patrickstreit/PD240W/PCB_files/production/bom.csv

Designator | Footprint | Quantity | Value | LCSC Part #
C1, C2, C5 | capc_1005_06_n | 3 | 10n X7R 100V | C527014
C10, C11, C12, C28, C29, C59, C60, C61, C67, C9 | capc_3225_27_n | 10 | 10u X7R 63V | C437568
C13, C14, C15 | capc_1608_09_n | 3 | 3.3u X5R 25V | C5360803
C16, C17, C21, C22, C23, C24, C25, C26, C27, C30, C34, C35, C37, C38, C39, C4, C40, C41, C42, C43, C44, C47, C48, C49, C50, C52, C53, C54, C55, C6, C63, C8 | capc_1608_09_l | 32 | 100n X7R 100V | C15725
C18 | capc_2012_14_m | 1 | 2.2u X7R 100V | C22367838
C19, C20 | capc_1005_06_l | 2 | 220p X7R 50V | C296710
C3 | capc_3225_22_n | 1 | 4.7u | C913445
C31, C32, C33, C36, C51, C56, C57, C58, C62, C64, C65, C66, C7 | capc_2012_14_n | 13 | 1u X7R 100V | C5370002
C45, C46 | capc_1005_06_n | 2 | 15p COG 50V | C1548
D1, D8 | do-214ac_440p_430x250x230_n_p | 2 | SMAJ48A | C41376401
D10, D7 | sot363_sc88_65p_200x125x110_n | 2 | D3V3F4U6S-7 | C1869321
D11 | SK6812-EC20 | 1 | SK6812-EC20 | C2909058
D12, D13 | sod-123fl_305p_260x160x90_n | 2 | MBR1H100SFT3G | C235757
D14, D4, D6, D9 | kingbright_0603_blue | 4 | APTD1608LQBC/D | C5344742
D2, D3 | sod-323_230p_170x125x100_n | 2 | BZT52C18SQ | C2857090
D5 | sod-123_270x155135_n | 1 | B0520LW-7-F | C155367
DSP1 | generic_display_518x362x2_10mm_standoff | 1 | HS20HS072RX | C5329582
F1, F2 | ptc_1206_08_n | 2 | FSMD020-1206-R | C220145
FB1 | fer_1608_09_n | 1 | BLM18SN220TH1D | C710392
J1 | DX07S024JJ2R1300 | 1 | DX07S024JJ2R1300 | C2977282
J3 | fcr7350r | 1 | 24.245.1 | C7437326
J4 | fcr7350b | 1 | 24.245.2 | C7437327
J5, J6 | phoenix_1935776 | 2 | 1935776 | C3817389
J8 | AFC07-S12FCA-00 | 1 | AFC07-S12FCA-00 | C262559
L1 | SWPA4030S220MT | 1 | 22uH 1A 0.29Ohm | C83472
L2 | SWPA4030S220MT | 1 | 68uH 0.55A 0.91Ohm | C340217
PZ1 | buzzer_9x9x2.1mm | 1 | FUET-9018 | C391035
Q1 | vsonp8_65p_330x330x80_mfg | 1 | AGM612AP | C5349119
Q2, Q4, Q5, Q6, Q7 | sot-23-3L_103p_300x130x110_n | 5 | AO3404A | C30010
Q3 | PowerPAKSO-8_127p_513x615x120_n | 1 | SQJB90EP-T1_GE3 | C727731
R1, R14, R15, R16, R17, R21, R27, R28, R29, R3, R75, R81, R85, R87, R88 | resc_1005_04_m | 15 | 100k 1% | C25741
R10, R13, R19, R31, R36, R41, R6, R69, R70, R71, R76, R77, R83, R86 | resc_1005_04_n | 14 | 10k 1% | C25744
R11, R12, R18, R25, R30, R8, R84, R89, R9, R90 | resc_1005_04_m | 10 | 4.7k 1% | C25900
R2, R33, R34, R4, R72, R78, R79, R80, R82 | resc_1005_04_n | 9 | 33k 1% | C138003
R20, R50, R68 | resc_1005_04_m | 3 | 330R 1% | C25104
R22 | WSLP1206_n_current_sense_6m_to_50m | 1 | 8m 1% | C2988654
R23, R24, R26, R37, R38, R39, R40, R42, R43, R44, R45, R46, R47, R48, R49, R51, R52, R56, R57, R58, R59, R60, R61, R62, R64, R65, R66, R7, R74 | resc_1005_04_m | 29 | 27R 1% | C138021
R32 | resc_1005_04_m | 1 | 10k @25°C | C95939
R35, R5, R53, R54, R55, R63, R67 | resc_1005_04_m | 7 | 1k 1% | C11702
R73 | resc_1005_04_m | 1 | 3.9R 1% | C2933095
S1, S2 | EVQPUC02K | 2 | EVQ-PUC02K | C79174
S3 | PEC11R-4215F-S0024 | 1 | PEC11R-4215F-S0024 | C143790
S4, S5 | GT-TC120A-H120-L1 | 2 | GT-TC120A-H120-L1 | C2762973
U1 | wqfn20_40p_300x300x80_tp_170x170_n | 1 | TPD4S480RUKR | C43131250
U10 | wson8_127p_600x500x80_tp_435x340_n | 1 | W25Q128JVPIQ | C190862
U11, U12 | sot6_p95_290x180x110_n | 2 | LMR16006XDDCR | C87080
U2 | sot236_p95_290x160x110_n | 1 | LM2765 | C140270
U3 | qfn32_40p_400x400x100_tp_280x280_mfg | 1 | TPS26750SRSMR | C42166327
U4 | msop_10p_300x490x110_tp168x188_n | 1 | LTC7004x | C690106
U5 | sot353_65p_200x125x110_mo-203-aa_n | 1 | 74LVC1G08SE-7 | C460522
U6 | JEDEC_MO-153_AA | 1 | CAT24C512YI-GT3 | C56096
U7 | sot25_95p_300x280x145_jedec_mo-178-aa_n | 1 | SN74LVC1G17DBVR | C7836
U8 | vssop10_50p_300x300x110_mfg | 1 | INA228AIDGSR | C2887910
U9 | qfn56_40p_700x700x90_tp_320x320_mfg | 1 | RP2040 | C2040
Y1 | osccc_320x205x80_abm8 | 1 | ABM8-272-T3 | C20625731
