patrickstreit/PD240W/PCB_files/PD240W_kicad.kicad_pcb

## KiCad design PCB_files/PD240W_kicad.kicad_pcb (2026-11-01)

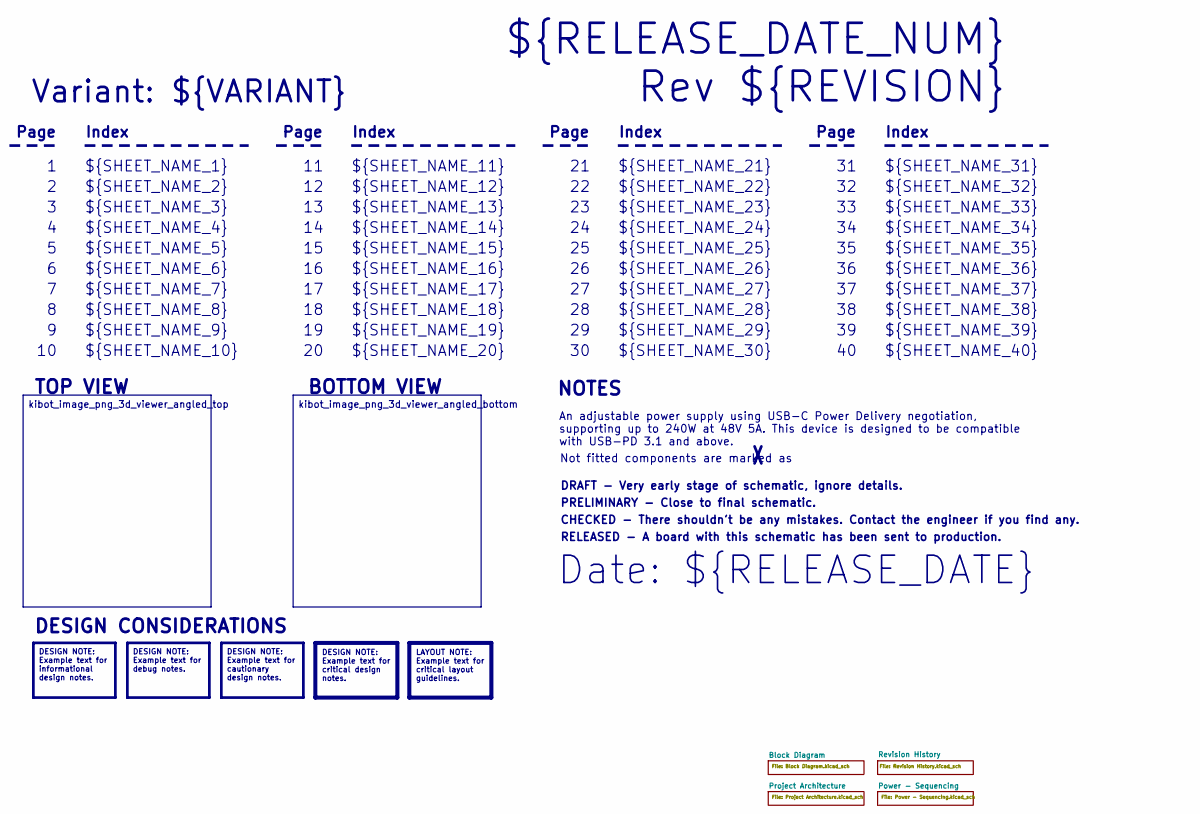
[picture p1: schematic PD240W_kicad.kicad_sch]

Notes on the sheet:
Variant: ${VARIANT}
RELEASED - A board with this schematic has been sent to production.
${SHEET_NAME_24}
Index
Page
PRELIMINARY - Close to final schematic.
${SHEET_NAME_22}
DRAFT - Very early stage of schematic, ignore details.
${SHEET_NAME_12}
${SHEET_NAME_8}
${SHEET_NAME_2}
${SHEET_NAME_5}
${SHEET_NAME_20}
${SHEET_NAME_23}
${RELEASE_DATE_NUM}
${SHEET_NAME_35}
Not fitted components are marked as
${SHEET_NAME_11}
${SHEET_NAME_6}
${SHEET_NAME_37}
${SHEET_NAME_26}
${SHEET_NAME_36}
Rev ${REVISION}
${SHEET_NAME_15}
CHECKED - There shouldn't be any mistakes. Contact the engineer if you find any.
BOTTOM VIEW
${SHEET_NAME_14}
${SHEET_NAME_21}
${SHEET_NAME_17}
${SHEET_NAME_18}
Date: ${RELEASE_DATE}
${SHEET_NAME_7}
${SHEET_NAME_31}
NOTES
${SHEET_NAME_40}
${SHEET_NAME_39}
${SHEET_NAME_32}
${SHEET_NAME_1}
${SHEET_NAME_9}
${SHEET_NAME_38}
${SHEET_NAME_29}
${SHEET_NAME_34}
${SHEET_NAME_16}
${SHEET_NAME_3}
${SHEET_NAME_19}
TOP VIEW
${SHEET_NAME_10}
${SHEET_NAME_28}
${SHEET_NAME_13}
${SHEET_NAME_27}
${SHEET_NAME_4}
${SHEET_NAME_33}
${SHEET_NAME_30}
${SHEET_NAME_25}
DESIGN CONSIDERATIONS
DESIGN NOTE: Example text for cautionary design notes.
DESIGN NOTE: Example text for debug notes.
DESIGN NOTE: Example text for critical design notes.
LAYOUT NOTE: Example text for critical layout guidelines.
kibot_image_png_3d_viewer_angled_bottom
DESIGN NOTE: Example text for informational design notes.
An adjustable power supply using USB-C Power Delivery negotiation, supporting up to 240W at 48V 5A. This device is designed to be compatible with USB-PD 3.1 and above.
kibot_image_png_3d_viewer_angled_top

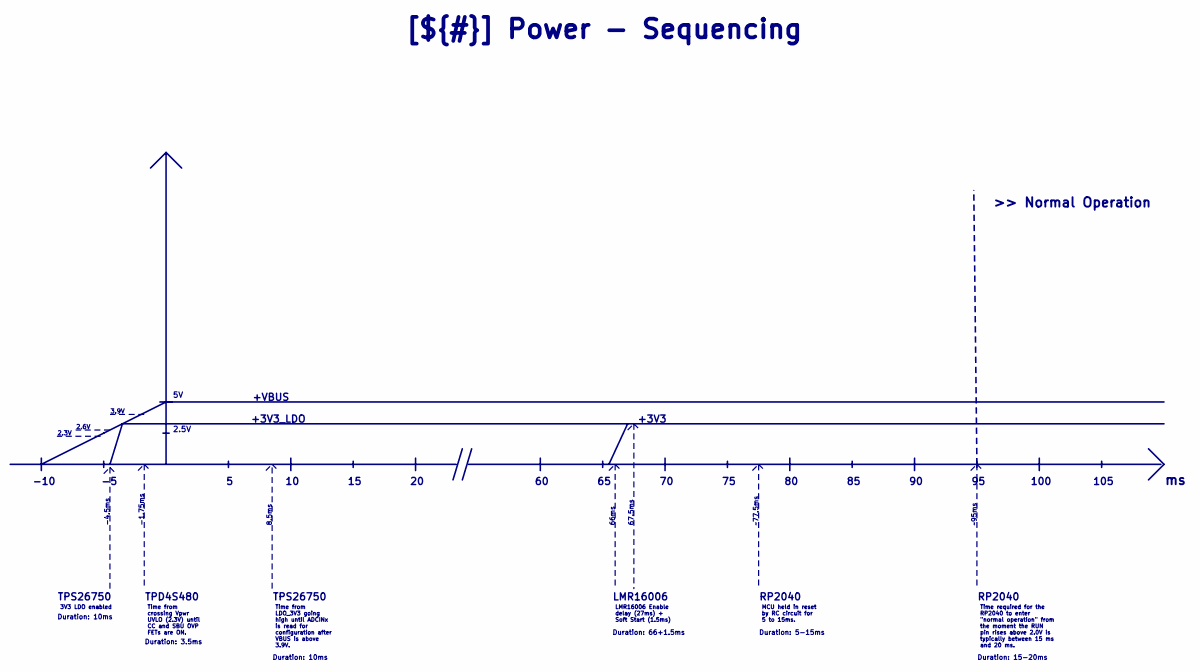
[picture p2: schematic Power - Sequencing.kicad_sch]

Notes on the sheet:
~95ms
-1.75ms
2.5V
3.9V
Duration: 15-20ms
RP2040
TPS26750
LMR16006
2.6V
+VBUS
Duration: 10ms
100
Duration: 3.5ms
Duration: 66+1.5ms
8.5ms
+3V3_LDO
66ms
67.5ms
Duration: 5-15ms
2.3V
105
~77.5ms
TPD4S480
+3V3
>> Normal Operation
-4.5ms
-10
3V3 LDO enabled
Time from LDO_3V3 going high until ADCINx is read for configuration after VBUS is above 3.9V.
Time from crossing Vpwr UVLO (2.3V) until CC and SBU OVP FETs are ON.
Time required for the RP2040 to enter "normal operation" from the moment the RUN pin rises above 2.0V is typically between 15 ms and 20 ms.
[${#}] ${TITLE}
MCU held in reset by RC circuit for 5 to 15ms.
LMR16006 Enable delay (27ms) + Soft Start (1.5ms)


Notes on the sheet:
${RELEASE_BODY_1.1.0}
[${#}] ${TITLE}
${RELEASE_BODY_1.0.0}
${RELEASE_TITLE_1.0.2}
${RELEASE_BODY_1.0.2}
${RELEASE_BODY_1.0.1}
${RELEASE_TITLE_1.0.0}
${RELEASE_TITLE_1.0.1}
${RELEASE_TITLE_1.1.0}

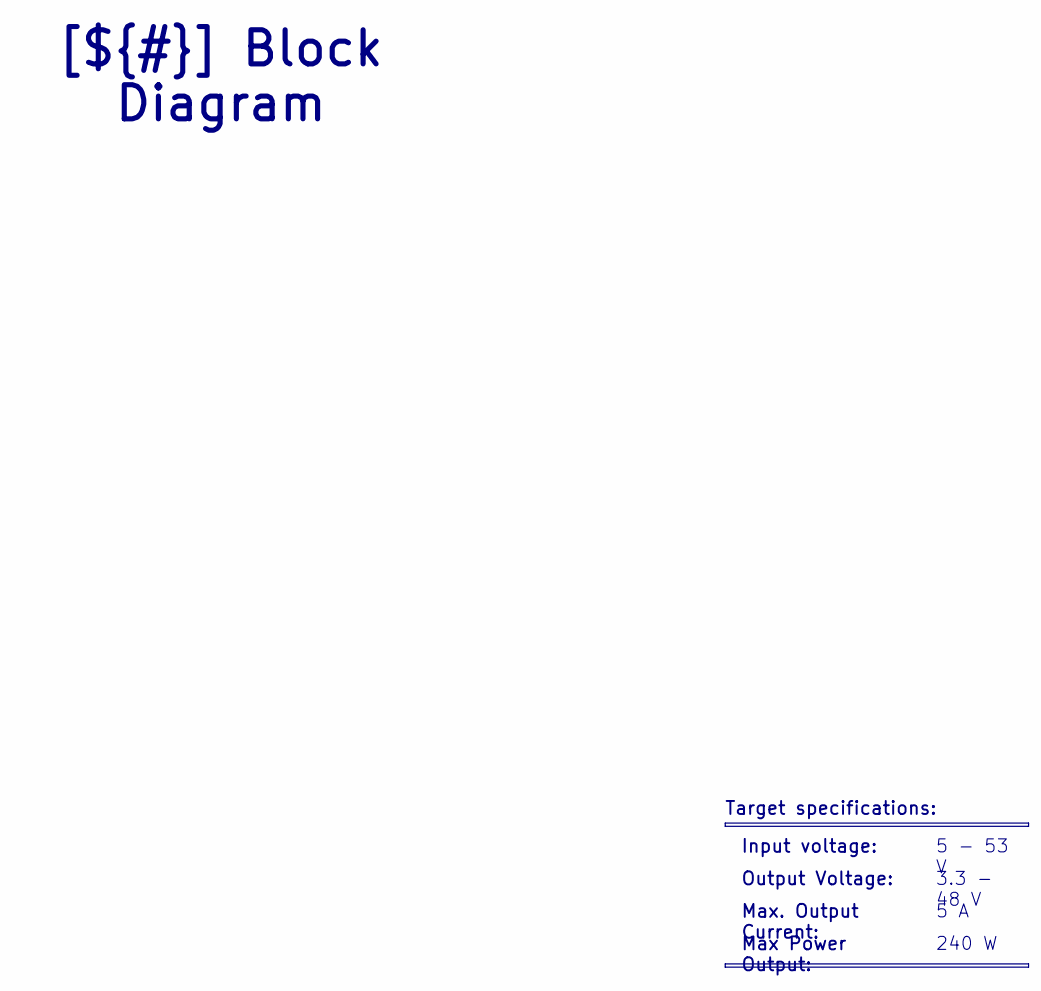
[picture p4: schematic Block Diagram.kicad_sch]

Notes on the sheet:
Max Power Output:
5 - 53 V
240 W
[${#}] ${TITLE}
3.3 - 48 V
Input voltage:
Target specifications:
Max. Output Current:
5 A
Output Voltage:

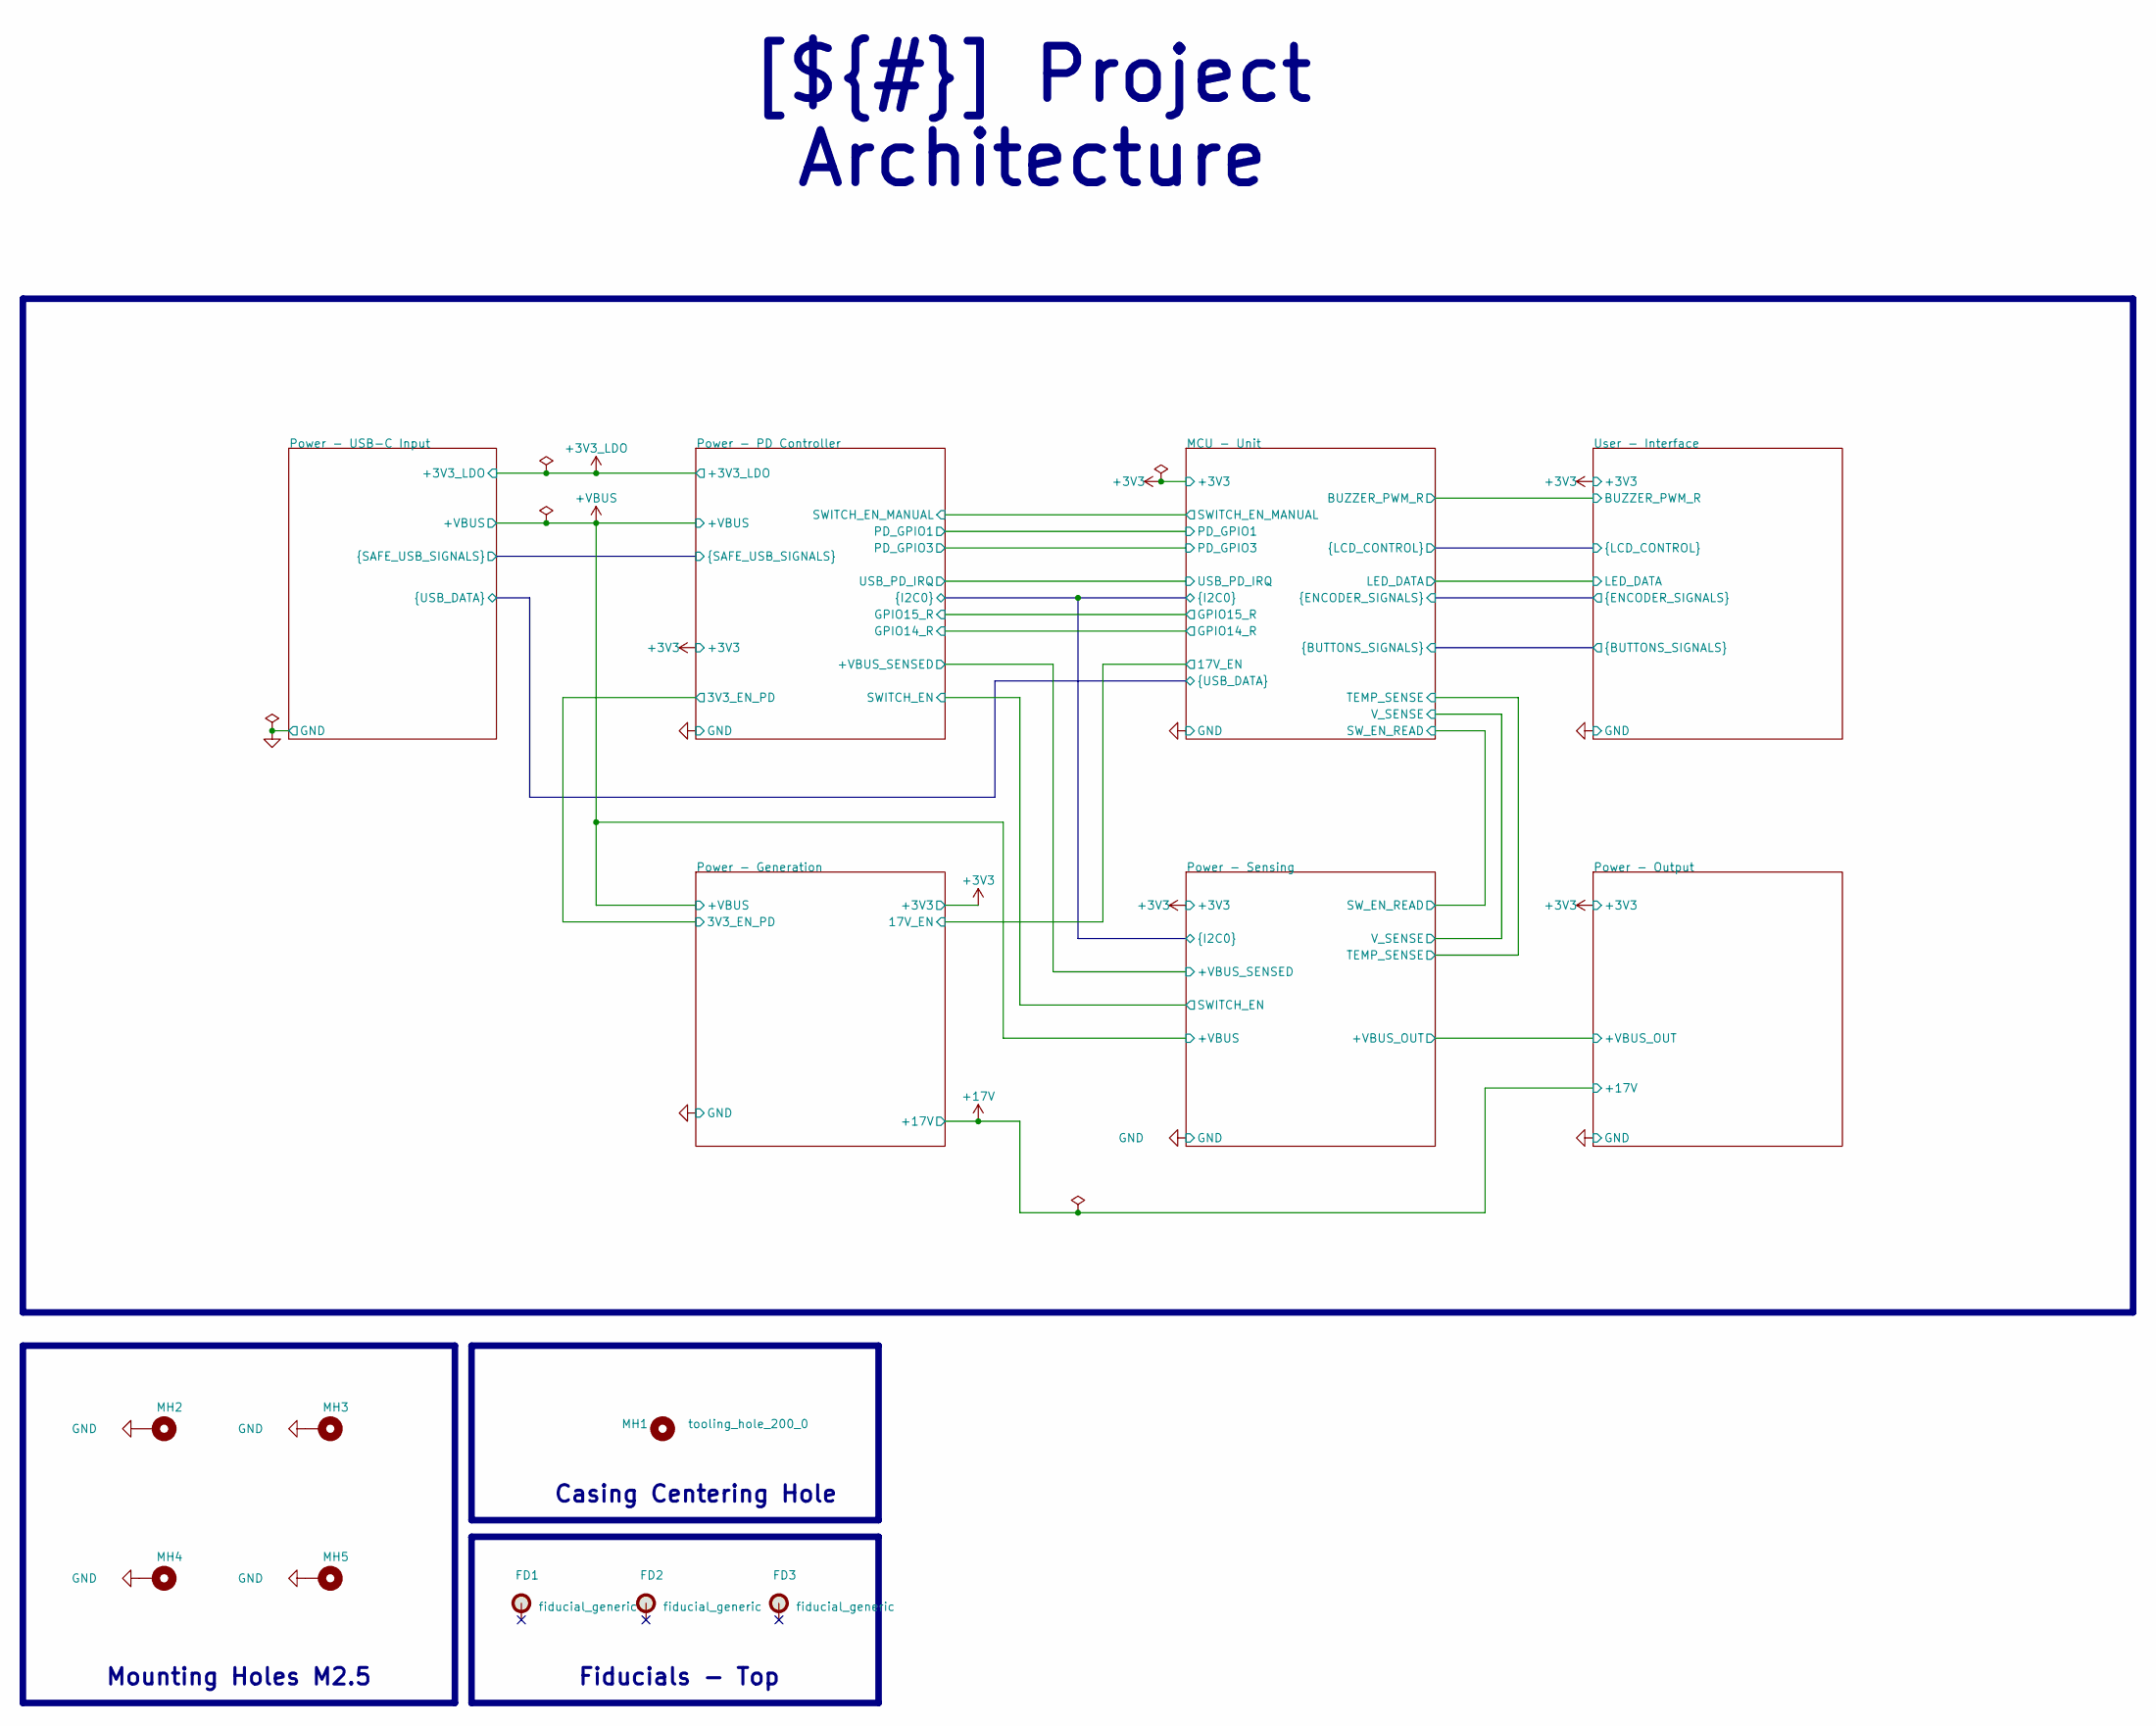
[picture p5: schematic Project Architecture.kicad_sch]

Parts:
FD1, FD2, FD3: fiducial_generic; fiducial_round_130
MH1: tooling_hole_200_0; tooling_hole_200_0_np
MH2, MH3, MH4, MH5: mounting_hole_270_540_p_via_8_50; MountingHole_2.7mm_M2.5_Pad_Via

Connections:
GND: MH2.1 (1_1), MH3.1 (1_1), MH4.1 (1_1), MH5.1 (1_1); also elsewhere on the board

Notes on the sheet:
Mounting Holes M2.5
Casing Centering Hole
Fiducials - Top
[${#}] ${TITLE}

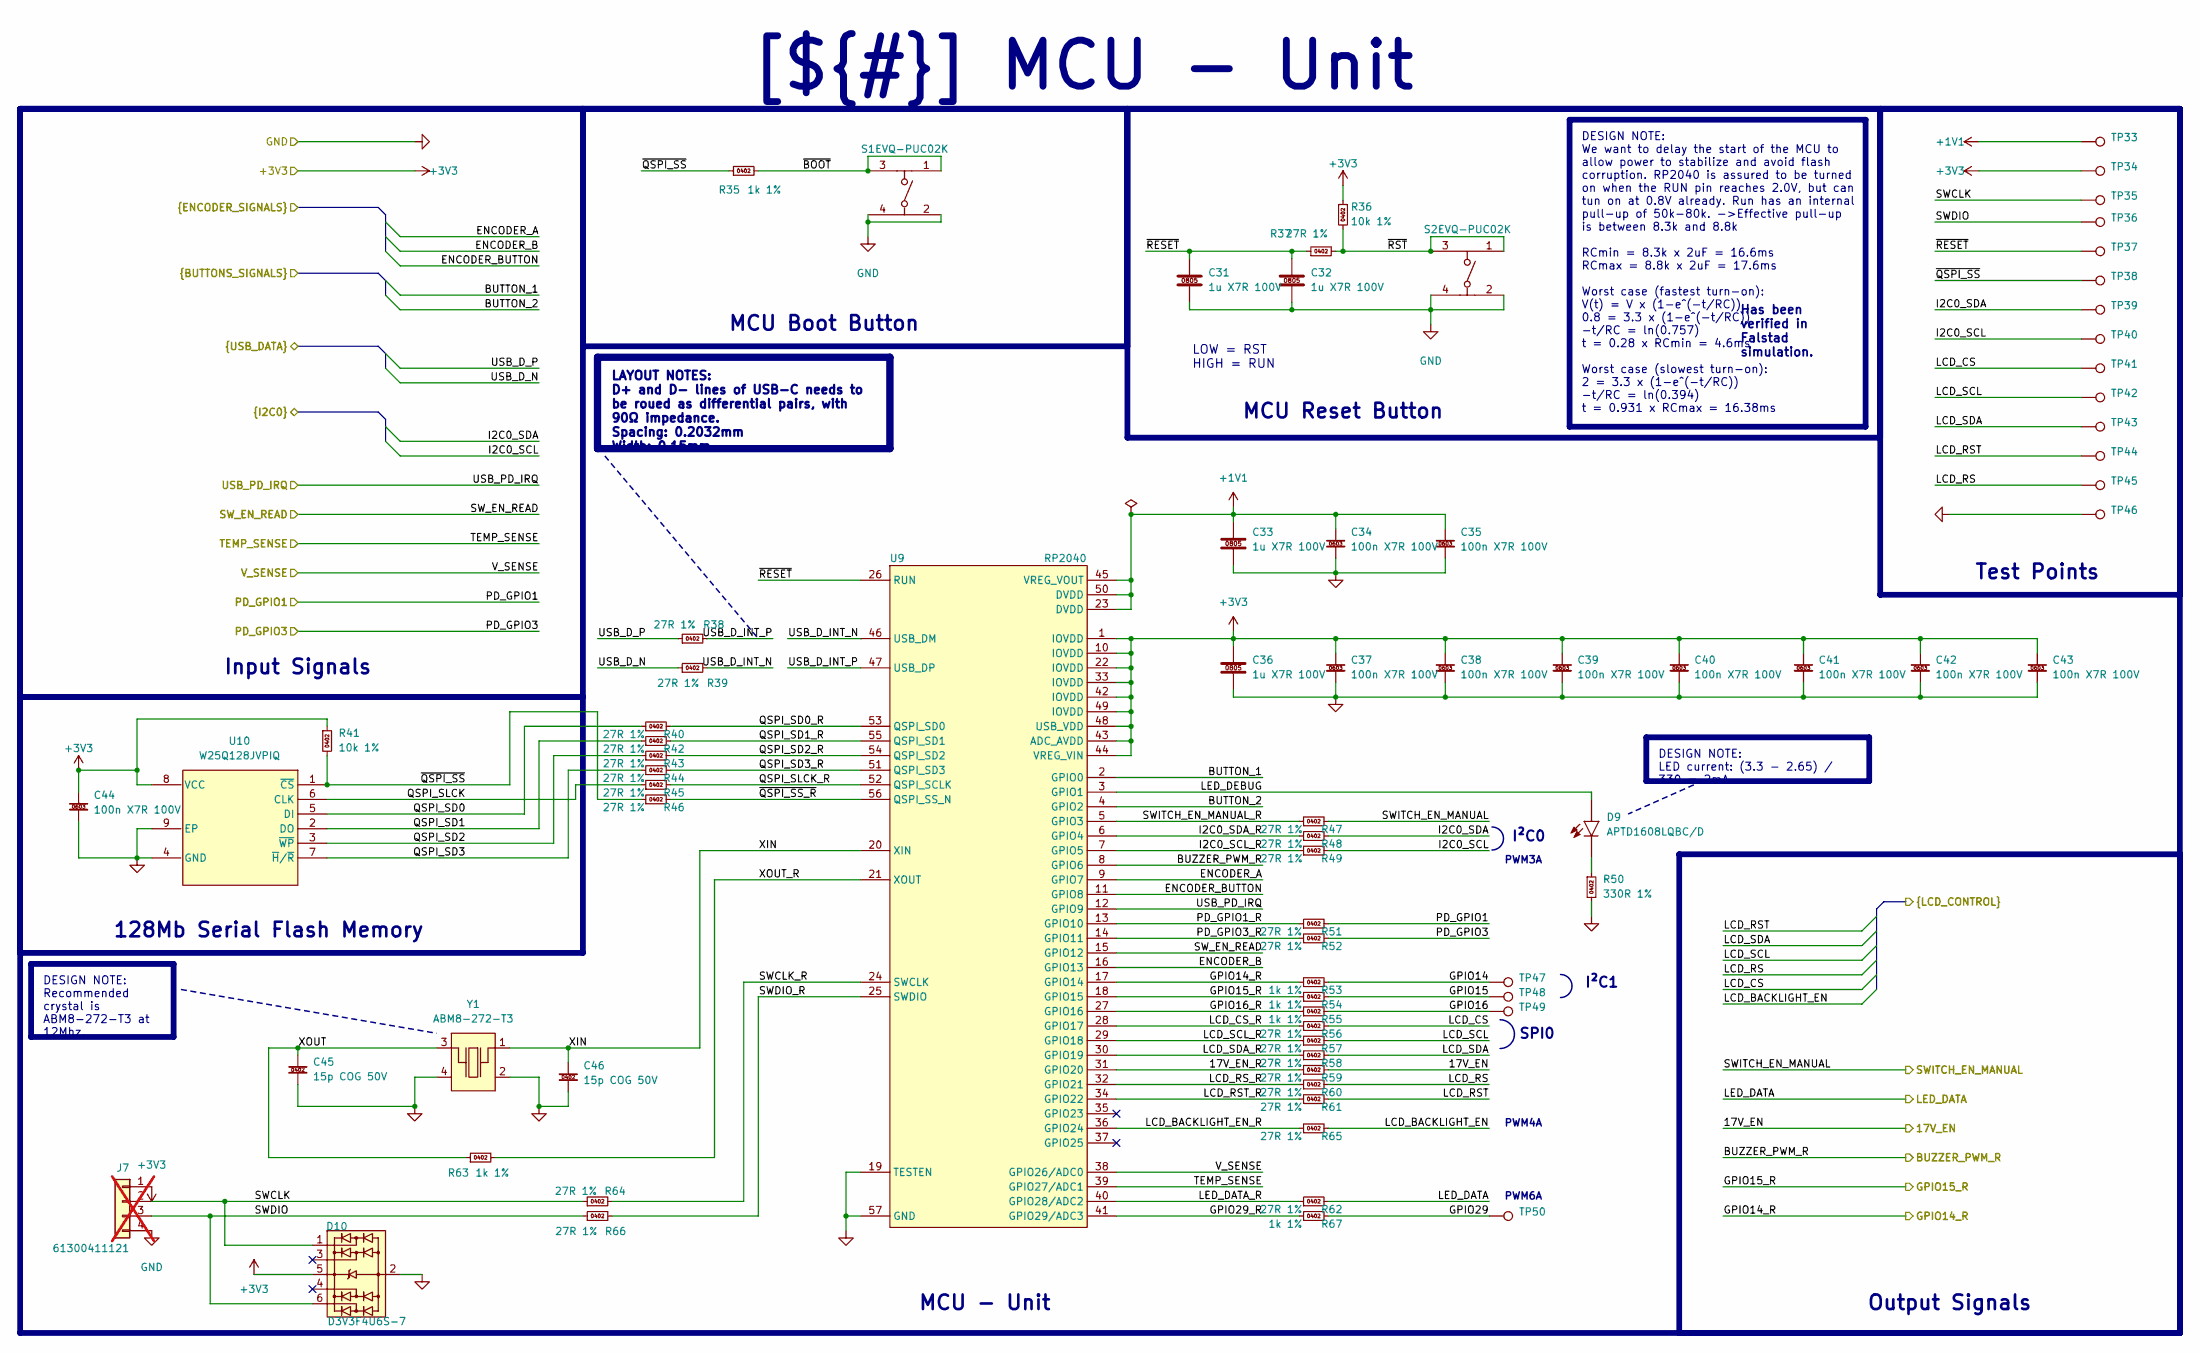
[picture p6: schematic mcu_unit.kicad_sch, MCU - Unit]

Parts:
C31, C32, C33, C36: 1u X7R 100V; capc_2012_14_n; Manufacturer Part Number CC0805KKX7R0BB105; LCSC C5370002
C34, C35, C37, C38, C39, C40, C41, C42, C43, C44: 100n X7R 100V; capc_1608_09_l; Manufacturer Part Number CL10B104KC8NNNC; LCSC C15725
C45, C46: 15p COG 50V; capc_1005_06_n; Manufacturer Part Number 0402CG150J500NT; LCSC C1548
D9: APTD1608LQBC/D; kingbright_0603_blue; Manufacturer Part Number APTD1608LQBC/D; LCSC C5344742
D10: D3V3F4U6S-7; sot363_sc88_65p_200x125x110_n; Manufacturer Part Number D3V3F4U6S-7; LCSC C1869321
J7: 61300411121; we_61300411121; Manufacturer Part Number 61300411121; LCSC C5184785; not fitted
R35, R53, R54, R55, R63, R67: 1k 1%; resc_1005_04_m; Manufacturer Part Number 0402WGF1001TCE; LCSC C11702
R36, R41: 10k 1%; resc_1005_04_n; Manufacturer Part Number 0402WGF1002TCE; LCSC C25744
R37, R38, R39, R40, R42, R43, R44, R45, R46, R47, R48, R49, R51, R52, R56, R57, R58, R59, R60, R61, R62, R64, R65, R66: 27R 1%; resc_1005_04_m; Manufacturer Part Number RC0402FR-0727RL; LCSC C138021
R50: 330R 1%; resc_1005_04_m; Manufacturer Part Number 0402WGF3300TCE; LCSC C25104
S1, S2: EVQ-PUC02K; EVQPUC02K; Manufacturer Part Number EVQ-PUC02K; LCSC C79174
TP33, TP34, TP35, TP36, TP37, TP38, TP39, TP40, TP41, TP42, TP43, TP44, TP45: tp_round_70
TP46, TP47, TP48, TP49, TP50: sp_oval_300x100
U9: RP2040; qfn56_40p_700x700x90_tp_320x320_mfg; Manufacturer Part Number SC0914(13); LCSC C2040
U10: W25Q128JVPIQ; wson8_127p_600x500x80_tp_435x340_n; Manufacturer Part Number W25Q128JVPIQ; LCSC C190862
Y1: ABM8-272-T3; osccc_320x205x80_abm8; Manufacturer Part Number ABM8-272-T3; LCSC C20625731

Connections:
+1V1: C33.1, C34.1, C35.1, TP33.1 (1_1), U9.23 (DVDD), U9.45 (VREG_VOUT), U9.50 (DVDD)
+3V3: C36.1, C37.1, C38.1, C39.1, C40.1, C41.1, C42.1, C43.1, C44.1, D10.5, J7.1, R36.1, R41.1, TP34.1 (1_1), U9.1 (IOVDD), U9.10 (IOVDD), U9.22 (IOVDD), U9.33 (IOVDD), U9.42 (IOVDD), U9.43 (ADC_AVDD), U9.44 (VREG_VIN), U9.48 (USB_VDD), U9.49 (IOVDD), U10.8 (VCC); also elsewhere on the board
/Project Architecture/MCU - Unit/17V_EN: R59.2; also elsewhere on the board
/Project Architecture/MCU - Unit/17V_EN_R: R59.1, U9.31 (GPIO20)
/Project Architecture/MCU - Unit/BUTTON_1: U9.2 (GPIO0); also elsewhere on the board
/Project Architecture/MCU - Unit/BUTTON_2: U9.4 (GPIO2); also elsewhere on the board
/Project Architecture/MCU - Unit/BUZZER_PWM_R: U9.8 (GPIO6); also elsewhere on the board
/Project Architecture/MCU - Unit/ENCODER_A: U9.9 (GPIO7); also elsewhere on the board
/Project Architecture/MCU - Unit/ENCODER_B: U9.16 (GPIO13); also elsewhere on the board
/Project Architecture/MCU - Unit/ENCODER_BUTTON: U9.11 (GPIO8); also elsewhere on the board
/Project Architecture/MCU - Unit/GPIO14: R53.2, TP47.1 (1_1)
/Project Architecture/MCU - Unit/GPIO14_R: R53.1, U9.17 (GPIO14); also elsewhere on the board
/Project Architecture/MCU - Unit/GPIO15: R54.2, TP48.1 (1_1)
/Project Architecture/MCU - Unit/GPIO15_R: R54.1, U9.18 (GPIO15); also elsewhere on the board
/Project Architecture/MCU - Unit/GPIO16: R55.2, TP49.1 (1_1)
/Project Architecture/MCU - Unit/GPIO16_R: R55.1, U9.27 (GPIO16)
/Project Architecture/MCU - Unit/GPIO29: R67.2, TP50.1 (1_1)
/Project Architecture/MCU - Unit/GPIO29_R: R67.1, U9.41 (GPIO29/ADC3)
/Project Architecture/MCU - Unit/I2C0_SCL: R49.2, TP40.1 (1_1); also elsewhere on the board
/Project Architecture/MCU - Unit/I2C0_SCL_R: R49.1, U9.7 (GPIO5)
/Project Architecture/MCU - Unit/I2C0_SDA: R48.2, TP39.1 (1_1); also elsewhere on the board
/Project Architecture/MCU - Unit/I2C0_SDA_R: R48.1, U9.6 (GPIO4)
/Project Architecture/MCU - Unit/LCD_BACKLIGHT_EN: R65.2; also elsewhere on the board
/Project Architecture/MCU - Unit/LCD_BACKLIGHT_EN_R: R65.1, U9.36 (GPIO24)
/Project Architecture/MCU - Unit/LCD_CS: R56.2, TP41.1 (1_1); also elsewhere on the board
/Project Architecture/MCU - Unit/LCD_CS_R: R56.1, U9.28 (GPIO17)
/Project Architecture/MCU - Unit/LCD_RS: R60.2, TP45.1 (1_1); also elsewhere on the board
/Project Architecture/MCU - Unit/LCD_RST: R61.2, TP44.1 (1_1); also elsewhere on the board
/Project Architecture/MCU - Unit/LCD_RST_R: R61.1, U9.34 (GPIO22)
/Project Architecture/MCU - Unit/LCD_RS_R: R60.1, U9.32 (GPIO21)
/Project Architecture/MCU - Unit/LCD_SCL: R57.2, TP42.1 (1_1); also elsewhere on the board
/Project Architecture/MCU - Unit/LCD_SCL_R: R57.1, U9.29 (GPIO18)
/Project Architecture/MCU - Unit/LCD_SDA: R58.2, TP43.1 (1_1); also elsewhere on the board
/Project Architecture/MCU - Unit/LCD_SDA_R: R58.1, U9.30 (GPIO19)
/Project Architecture/MCU - Unit/LED_DATA: R62.2; also elsewhere on the board
/Project Architecture/MCU - Unit/LED_DATA_R: R62.1, U9.40 (GPIO28/ADC2)
/Project Architecture/MCU - Unit/LED_DEBUG: D9.2 (A), U9.3 (GPIO1)
/Project Architecture/MCU - Unit/PD_GPIO1: R51.2; also elsewhere on the board
/Project Architecture/MCU - Unit/PD_GPIO1_R: R51.1, U9.13 (GPIO10)
/Project Architecture/MCU - Unit/PD_GPIO3: R52.2; also elsewhere on the board
/Project Architecture/MCU - Unit/PD_GPIO3_R: R52.1, U9.14 (GPIO11)
/Project Architecture/MCU - Unit/QSPI_SD0: R40.1, U10.5 (DI)
/Project Architecture/MCU - Unit/QSPI_SD0_R: R40.2, U9.53 (QSPI_SD0)
/Project Architecture/MCU - Unit/QSPI_SD1: R42.1, U10.2 (DO)
/Project Architecture/MCU - Unit/QSPI_SD1_R: R42.2, U9.55 (QSPI_SD1)
/Project Architecture/MCU - Unit/QSPI_SD2: R43.1, U10.3 (~WP)
/Project Architecture/MCU - Unit/QSPI_SD2_R: R43.2, U9.54 (QSPI_SD2)
/Project Architecture/MCU - Unit/QSPI_SD3: R44.1, U10.7 (~H/~R)
/Project Architecture/MCU - Unit/QSPI_SD3_R: R44.2, U9.51 (QSPI_SD3)
/Project Architecture/MCU - Unit/QSPI_SLCK: R45.1, U10.6 (CLK)
/Project Architecture/MCU - Unit/QSPI_SLCK_R: R45.2, U9.52 (QSPI_SCLK)
/Project Architecture/MCU - Unit/SWCLK: D10.1, J7.2, R64.1, TP35.1 (1_1)
/Project Architecture/MCU - Unit/SWCLK_R: R64.2, U9.24 (SWCLK)
/Project Architecture/MCU - Unit/SWDIO: D10.6, J7.3, R66.1, TP36.1 (1_1)
/Project Architecture/MCU - Unit/SWDIO_R: R66.2, U9.25 (SWDIO)
/Project Architecture/MCU - Unit/SWITCH_EN_MANUAL: R47.2; also elsewhere on the board
/Project Architecture/MCU - Unit/SWITCH_EN_MANUAL_R: R47.1, U9.5 (GPIO3)
/Project Architecture/MCU - Unit/SW_EN_READ: U9.15 (GPIO12); also elsewhere on the board
/Project Architecture/MCU - Unit/TEMP_SENSE: U9.39 (GPIO27/ADC1); also elsewhere on the board
/Project Architecture/MCU - Unit/USB_D_INT_N: R39.2, U9.46 (USB_DM)
/Project Architecture/MCU - Unit/USB_D_INT_P: R38.2, U9.47 (USB_DP)
/Project Architecture/MCU - Unit/USB_D_N: R39.1; also elsewhere on the board
/Project Architecture/MCU - Unit/USB_D_P: R38.1; also elsewhere on the board
/Project Architecture/MCU - Unit/USB_PD_IRQ: U9.12 (GPIO9); also elsewhere on the board
/Project Architecture/MCU - Unit/V_SENSE: U9.38 (GPIO26/ADC0); also elsewhere on the board
/Project Architecture/MCU - Unit/XIN: C46.1, U9.20 (XIN), Y1.1
/Project Architecture/MCU - Unit/XOUT: C45.1, R63.1, Y1.3
/Project Architecture/MCU - Unit/XOUT_R: R63.2, U9.21 (XOUT)
/Project Architecture/MCU - Unit/~BOOT: R35.2, S1.1, S1.3
/Project Architecture/MCU - Unit/~QSPI_SS_R: R46.2, U9.56 (QSPI_SS_N)
/Project Architecture/MCU - Unit/~QSPI_SS: R35.1, R41.2, R46.1, TP38.1 (1_1), U10.1 (~CS)
/Project Architecture/MCU - Unit/~RESET: C31.1, C32.1, R37.1, TP37.1 (1_1), U9.26 (RUN)
/Project Architecture/MCU - Unit/~RST: R36.2, R37.2, S2.1, S2.3
GND: C31.2, C32.2, C33.2, C34.2, C35.2, C36.2, C37.2, C38.2, C39.2, C40.2, C41.2, C42.2, C43.2, C44.2, C45.2, C46.2, D10.2, J7.4, R50.2, S1.2, S1.4, S2.2, S2.4, TP46.1 (1_1), U9.19 (TESTEN), U9.57 (GND), U10.4 (GND), U10.9 (EP), Y1.2, Y1.4; also elsewhere on the board
unnamed: D9.1 (C), R50.1

Notes on the sheet:
PWM4A
MCU Boot Button
MCU Reset Button
Input Signals
128Mb Serial Flash Memory
Test Points
I²C1
Output Signals
SPI0
I²C0
PWM6A
${TITLE}
PWM3A
LOW = RST HIGH = RUN
LAYOUT NOTES: D+ and D- lines of USB-C needs to be roued as differential pairs, with 90Ω impedance. Spacing: 0.2032mm Width: 0.15mm
DESIGN NOTE: We want to delay the start of the MCU to allow power to stabilize and avoid flash corruption. RP2040 is assured to be turned on when the RUN pin reaches 2.0V, but can tun on at 0.8V already. Run has an internal pull-up of 50k-80k. ->Effective pull-up is between 8.3k and 8.8k RCmin = 8.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
DESIGN NOTE: Recommended crystal is ABM8-272-T3 at 12Mhz.
Has been verified in Falstad simulation.
DESIGN NOTE: LED current: (3.3 - 2.65) / 330 = 2mA
[${#}] ${TITLE}

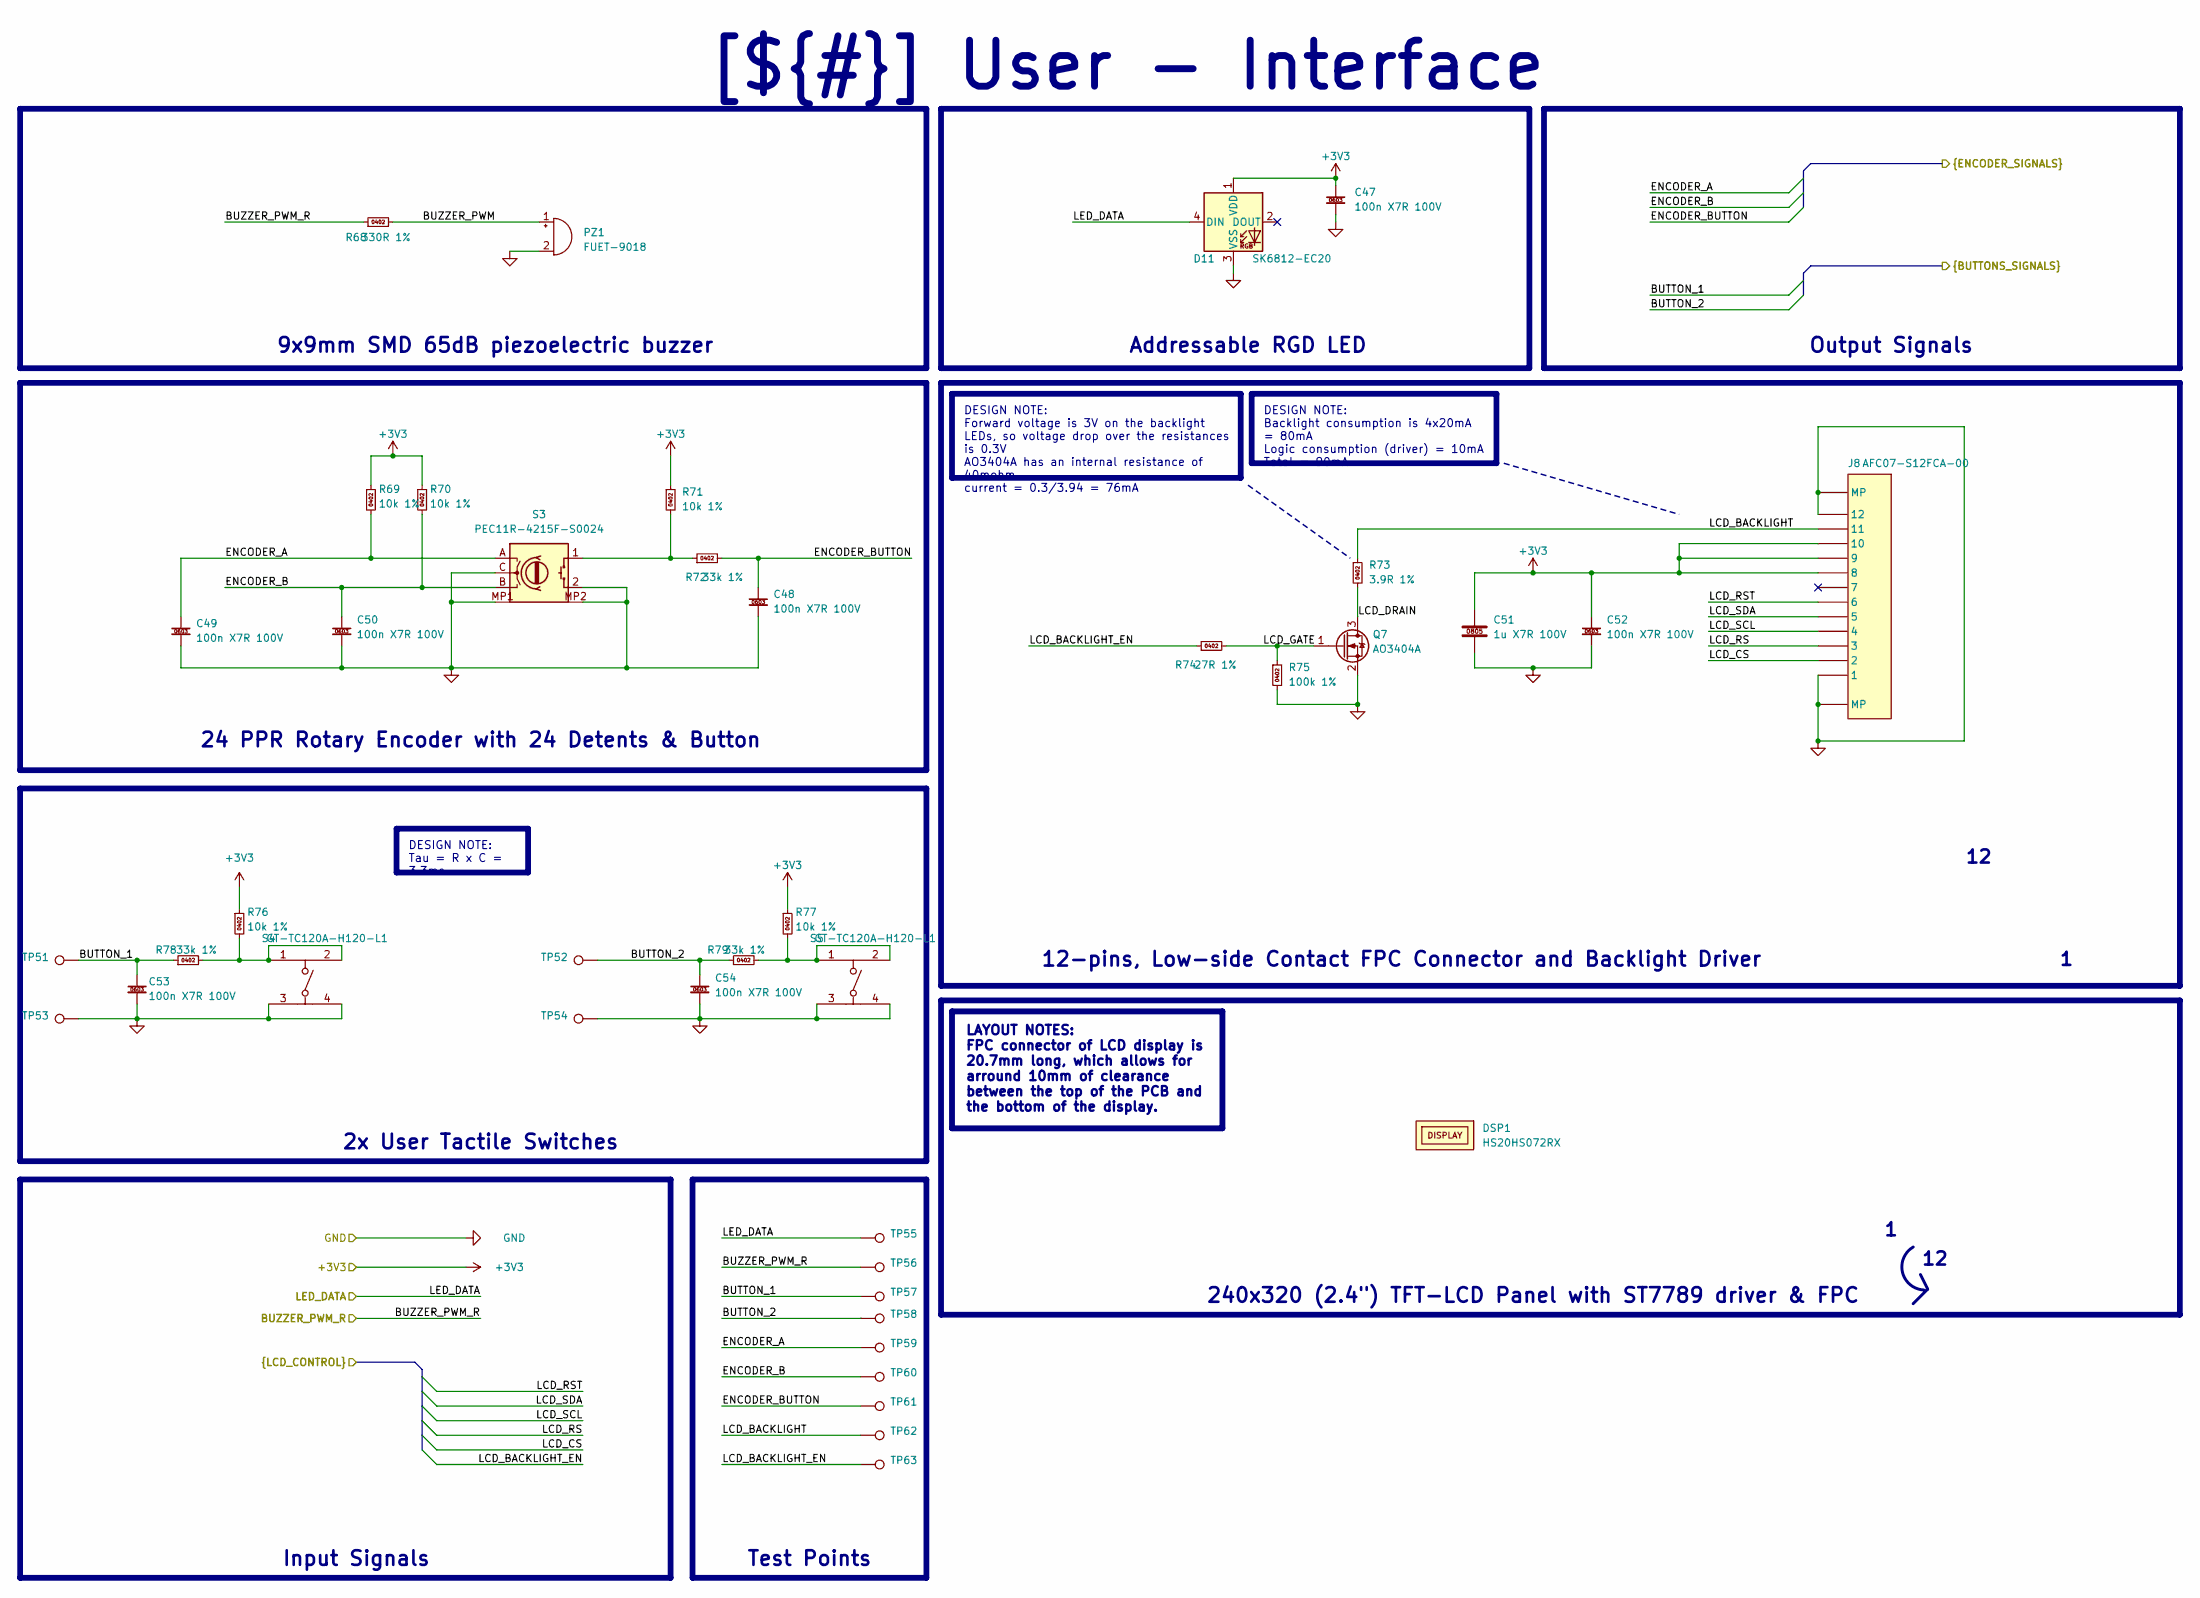
[picture p7: schematic user_interface.kicad_sch, User - Interface]

Parts:
C47, C48, C49, C50, C52, C53, C54: 100n X7R 100V; capc_1608_09_l; Manufacturer Part Number CL10B104KC8NNNC; LCSC C15725
C51: 1u X7R 100V; capc_2012_14_n; Manufacturer Part Number CC0805KKX7R0BB105; LCSC C5370002
D11: SK6812-EC20; Manufacturer Part Number SK6812-EC20; LCSC C2909058
DSP1: HS20HS072RX; generic_display_518x362x2_10mm_standoff; Manufacturer Part Number HS20HS072RX; LCSC C5329582
J8: AFC07-S12FCA-00; Manufacturer Part Number AFC07-S12FCA-00; LCSC C262559
PZ1: FUET-9018; buzzer_9x9x2.1mm; Manufacturer Part Number FUET-9018; LCSC C391035
Q7: AO3404A; sot-23-3L_103p_300x130x110_n; Manufacturer Part Number AO3404A; LCSC C30010
R68: 330R 1%; resc_1005_04_m; Manufacturer Part Number 0402WGF3300TCE; LCSC C25104
R69, R70, R71, R76, R77: 10k 1%; resc_1005_04_n; Manufacturer Part Number 0402WGF1002TCE; LCSC C25744
R72, R78, R79: 33k 1%; resc_1005_04_n; Manufacturer Part Number RC0402FR-0733KL; LCSC C138003
R73: 3.9R 1%; resc_1005_04_m; Manufacturer Part Number FRC0402F3R90TS; LCSC C2933095
R74: 27R 1%; resc_1005_04_m; Manufacturer Part Number RC0402FR-0727RL; LCSC C138021
R75: 100k 1%; resc_1005_04_m; Manufacturer Part Number 0402WGF1003TCE; LCSC C25741
S3: PEC11R-4215F-S0024; Manufacturer Part Number PEC11R-4215F-S0024; LCSC C143790
S4, S5: GT-TC120A-H120-L1; Manufacturer Part Number GT-TC120A-H120-L1; LCSC C2762973
TP51, TP52, TP53, TP54: sp_oval_300x100
TP55, TP56, TP57, TP58, TP59, TP60, TP61, TP62, TP63: tp_round_70

Connections:
+3V3: C47.1, C51.1, C52.1, D11.1 (VDD), J8.8, J8.9, J8.10, R69.1, R70.1, R71.1, R76.1, R77.1; also elsewhere on the board
/Project Architecture/MCU - Unit/BUTTON_1: C53.1, R78.1, TP51.1 (1_1), TP57.1 (1_1); also elsewhere on the board
/Project Architecture/MCU - Unit/BUTTON_2: C54.1, R79.1, TP52.1 (1_1), TP58.1 (1_1); also elsewhere on the board
/Project Architecture/MCU - Unit/BUZZER_PWM_R: R68.1, TP56.1 (1_1); also elsewhere on the board
/Project Architecture/MCU - Unit/ENCODER_A: C49.1, R69.2, S3.A, TP59.1 (1_1); also elsewhere on the board
/Project Architecture/MCU - Unit/ENCODER_B: C50.1, R70.2, S3.B, TP60.1 (1_1); also elsewhere on the board
/Project Architecture/MCU - Unit/ENCODER_BUTTON: C48.1, R72.2, TP61.1 (1_1); also elsewhere on the board
/Project Architecture/MCU - Unit/LCD_BACKLIGHT_EN: R74.1, TP63.1 (1_1); also elsewhere on the board
/Project Architecture/MCU - Unit/LCD_CS: J8.2; also elsewhere on the board
/Project Architecture/MCU - Unit/LCD_RS: J8.3; also elsewhere on the board
/Project Architecture/MCU - Unit/LCD_RST: J8.6; also elsewhere on the board
/Project Architecture/MCU - Unit/LCD_SCL: J8.4; also elsewhere on the board
/Project Architecture/MCU - Unit/LCD_SDA: J8.5; also elsewhere on the board
/Project Architecture/MCU - Unit/LED_DATA: D11.4 (DIN), TP55.1 (1_1); also elsewhere on the board
/Project Architecture/User - Interface/BUZZER_PWM: PZ1.1 (+), R68.2
/Project Architecture/User - Interface/LCD_BACKLIGHT: J8.11, R73.1, TP62.1 (1_1)
/Project Architecture/User - Interface/LCD_DRAIN: Q7.3 (D), R73.2
/Project Architecture/User - Interface/LCD_GATE: Q7.1 (G), R74.2, R75.1
GND: C47.2, C48.2, C49.2, C50.2, C51.2, C52.2, C53.2, C54.2, D11.3 (VSS), J8.1, J8.12, J8.MP1 (MP), J8.MP2 (MP), PZ1.2 (-), Q7.2 (S), R75.2, S3.2, S3.C, S3.MP1, S3.MP2, S4.3, S4.4, S5.3, S5.4, TP53.1 (1_1), TP54.1 (1_1); also elsewhere on the board
unnamed: R71.2, R72.1, S3.1
unnamed: R76.2, R78.2, S4.1, S4.2
unnamed: R77.2, R79.2, S5.1, S5.2

Notes on the sheet:
9x9mm SMD 65dB piezoelectric buzzer
Addressable RGD LED
12-pins, Low-side Contact FPC Connector and Backlight Driver
240x320 (2.4") TFT-LCD Panel with ST7789 driver & FPC
24 PPR Rotary Encoder with 24 Detents & Button
Input Signals
Test Points
Output Signals
2x User Tactile Switches
DESIGN NOTE: Backlight consumption is 4x20mA = 80mA Logic consumption (driver) = 10mA Total = 90mA
DESIGN NOTE: Tau = R x C = 3.3ms
DESIGN NOTE: Forward voltage is 3V on the backlight LEDs, so voltage drop over the resistances is 0.3V AO3404A has an internal resistance of 40mohm. current = 0.3/3.94 = 76mA
LAYOUT NOTES: FPC connector of LCD display is 20.7mm long, which allows for arround 10mm of clearance between the top of the PCB and the bottom of the display.
[${#}] ${TITLE}
