patrickstreit/PD240W/PCB_files/PD240W_kicad.kicad_pcb

## KiCad design PCB_files/PD240W_kicad.kicad_pcb (continued)

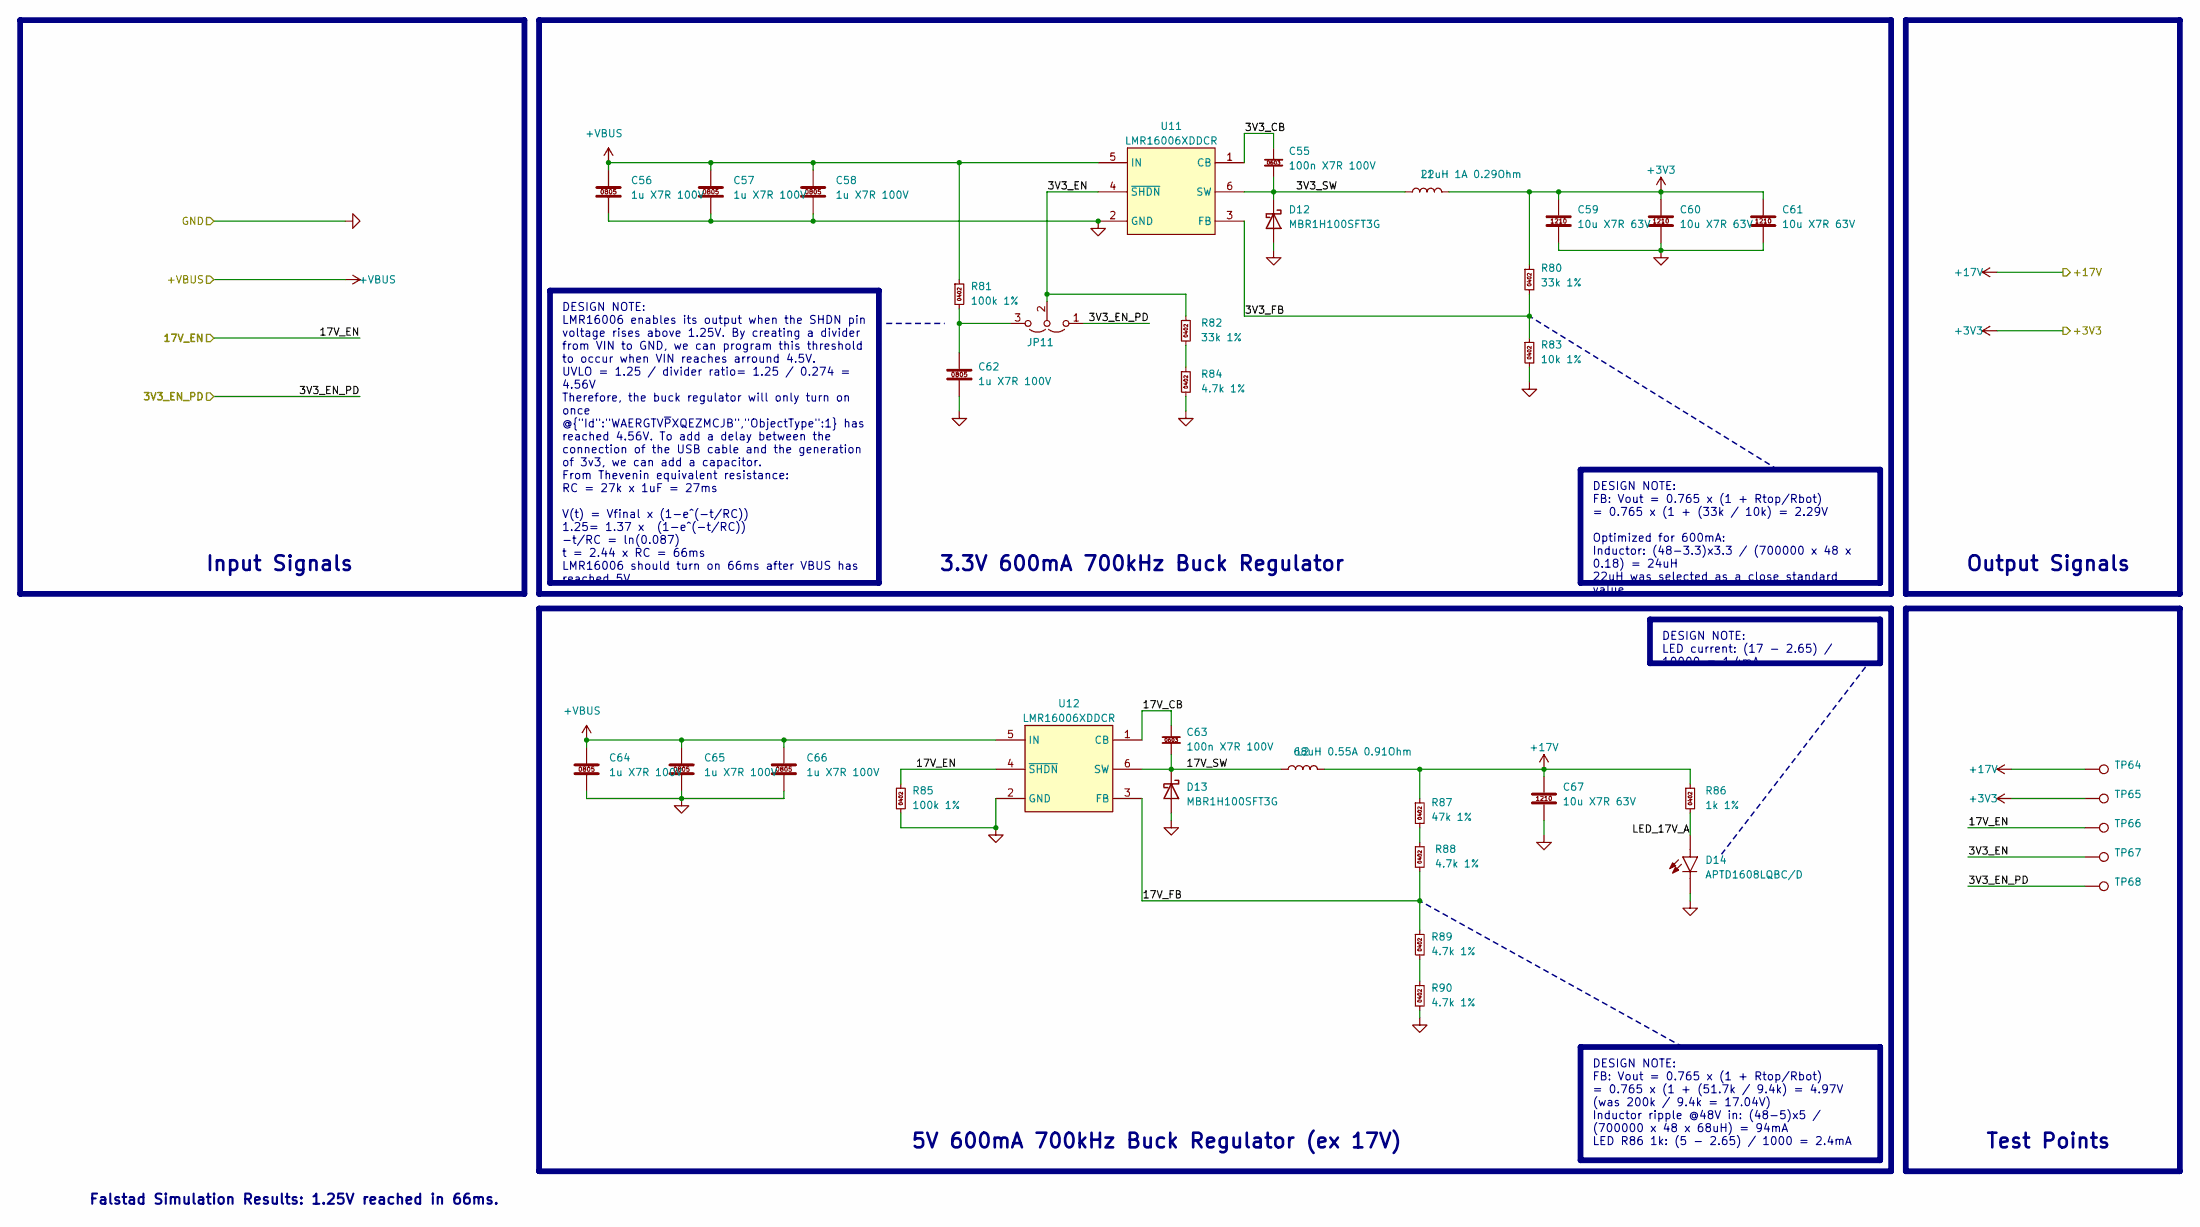
[picture p8: schematic power_generation.kicad_sch, Power - Generation]

Parts:
C55, C63: 100n X7R 100V; capc_1608_09_l; Manufacturer Part Number CL10B104KC8NNNC; LCSC C15725
C56, C57, C58, C62, C64, C65, C66: 1u X7R 100V; capc_2012_14_n; Manufacturer Part Number CC0805KKX7R0BB105; LCSC C5370002
C59, C60, C61, C67: 10u X7R 63V; capc_3225_27_n; Manufacturer Part Number GRM32ER71J106KA12L; LCSC C437568
D12, D13: MBR1H100SFT3G; sod-123fl_305p_260x160x90_n; Manufacturer Part Number MBR1H100SFT3G; LCSC C235757
D14: APTD1608LQBC/D; kingbright_0603_blue; Manufacturer Part Number APTD1608LQBC/D; LCSC C5344742
JP11: jumper_solder_3pad_no; jumper_solder_3pad_no_40x40_20
L1: 22uH 1A 0.29Ohm; SWPA4030S220MT; Manufacturer Part Number SWPA4030S220MT; LCSC C83472
L2: 68uH 0.55A 0.91Ohm; SWPA4030S220MT; Manufacturer Part Number ASWPA4035S680MT; LCSC C340217
R80, R82: 33k 1%; resc_1005_04_n; Manufacturer Part Number RC0402FR-0733KL; LCSC C138003
R81, R85: 100k 1%; resc_1005_04_m; Manufacturer Part Number 0402WGF1003TCE; LCSC C25741
R83: 10k 1%; resc_1005_04_n; Manufacturer Part Number 0402WGF1002TCE; LCSC C25744
R84, R88, R89, R90: 4.7k 1%; resc_1005_04_m; Manufacturer Part Number 0402WGF4701TCE; LCSC C25900
R86: 1k 1%; resc_1005_04_n; Manufacturer Part Number 0402WGF1001TCE; LCSC C11702
R87: 47k 1%; resc_1005_04_m; Manufacturer Part Number 0402WGF4702TCE; LCSC C25792
TP64, TP65, TP66, TP67, TP68: tp_round_70
U11, U12: LMR16006XDDCR; sot6_p95_290x180x110_n; Manufacturer Part Number LMR16006XDDCR; LCSC C87080

Connections:
+3V3: C59.1, C60.1, C61.1, L1.2, R80.1, TP65.1 (1_1); also elsewhere on the board
+17V: C67.1, L2.2, R86.1, R87.1, TP64.1 (1_1); also elsewhere on the board
+VBUS: C56.1, C57.1, C58.1, C64.1, C65.1, C66.1, R81.1, U11.5 (IN), U12.5 (IN); also elsewhere on the board
/Project Architecture/MCU - Unit/17V_EN: R85.1, TP66.1 (1_1), U12.4 (~SHDN); also elsewhere on the board
/Project Architecture/Power - Generation/3V3_CB: C55.1, U11.1 (CB)
/Project Architecture/Power - Generation/3V3_EN: JP11.2 (C), R82.1, TP67.1 (1_1), U11.4 (~SHDN)
/Project Architecture/Power - Generation/3V3_EN_PD: JP11.1 (A), TP68.1 (1_1); also elsewhere on the board
/Project Architecture/Power - Generation/3V3_FB: R80.2, R83.1, U11.3 (FB)
/Project Architecture/Power - Generation/3V3_SW: C55.2, D12.1 (K), L1.1, U11.6 (SW)
/Project Architecture/Power - Generation/17V_CB: C63.1, U12.1 (CB)
/Project Architecture/Power - Generation/17V_FB: R88.2, R89.1, U12.3 (FB)
/Project Architecture/Power - Generation/17V_SW: C63.2, D13.1 (K), L2.1, U12.6 (SW)
/Project Architecture/Power - Generation/LED_17V_A: D14.2 (A), R86.2
GND: C56.2, C57.2, C58.2, C59.2, C60.2, C61.2, C62.2, C64.2, C65.2, C66.2, C67.2, D12.2 (A), D13.2 (A), D14.1 (C), R83.2, R84.2, R85.2, R90.2, U11.2 (GND), U12.2 (GND); also elsewhere on the board
unnamed: C62.1, JP11.3 (B), R81.2
unnamed: R82.2, R84.1
unnamed: R87.2, R88.1
unnamed: R89.2, R90.1

Notes on the sheet:
Input Signals
Output Signals
Test Points
3.3V 600mA 700kHz Buck Regulator
Falstad Simulation Results: 1.25V reached in 66ms.
5V 600mA 700kHz Buck Regulator (ex 17V)
DESIGN NOTE: LMR16006 enables its output when the SHDN pin voltage rises above 1.25V. By creating a divider from VIN to GND, we can program this threshold to occur when VIN reaches arround 4.5V. UVLO = 1.25 / divider ratio= 1.25 / 0.274 = 4.56V Therefore, the buck regulator will only turn on once @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
DESIGN NOTE: FB: Vout = 0.765 x (1 + Rtop/Rbot) = 0.765 x (1 + (33k / 10k) = 2.29V Optimized for 600mA: Inductor: (48-3.3)x3.3 / (700000 x 48 x 0.18) = 24uH 22uH was selected as a close standard value.
DESIGN NOTE: LED current: (17 - 2.65) / 10000 = 1.4mA
DESIGN NOTE: FB: Vout = 0.765 x (1 + Rtop/Rbot) = 0.765 x (1 + (51.7k / 9.4k) = 4.97V (was 200k / 9.4k = 17.04V) Inductor ripple @48V in: (48-5)x5 / (700000 x 48 x 68uH) = 94mA LED R86 1k: (5 - 2.65) / 1000 = 2.4mA

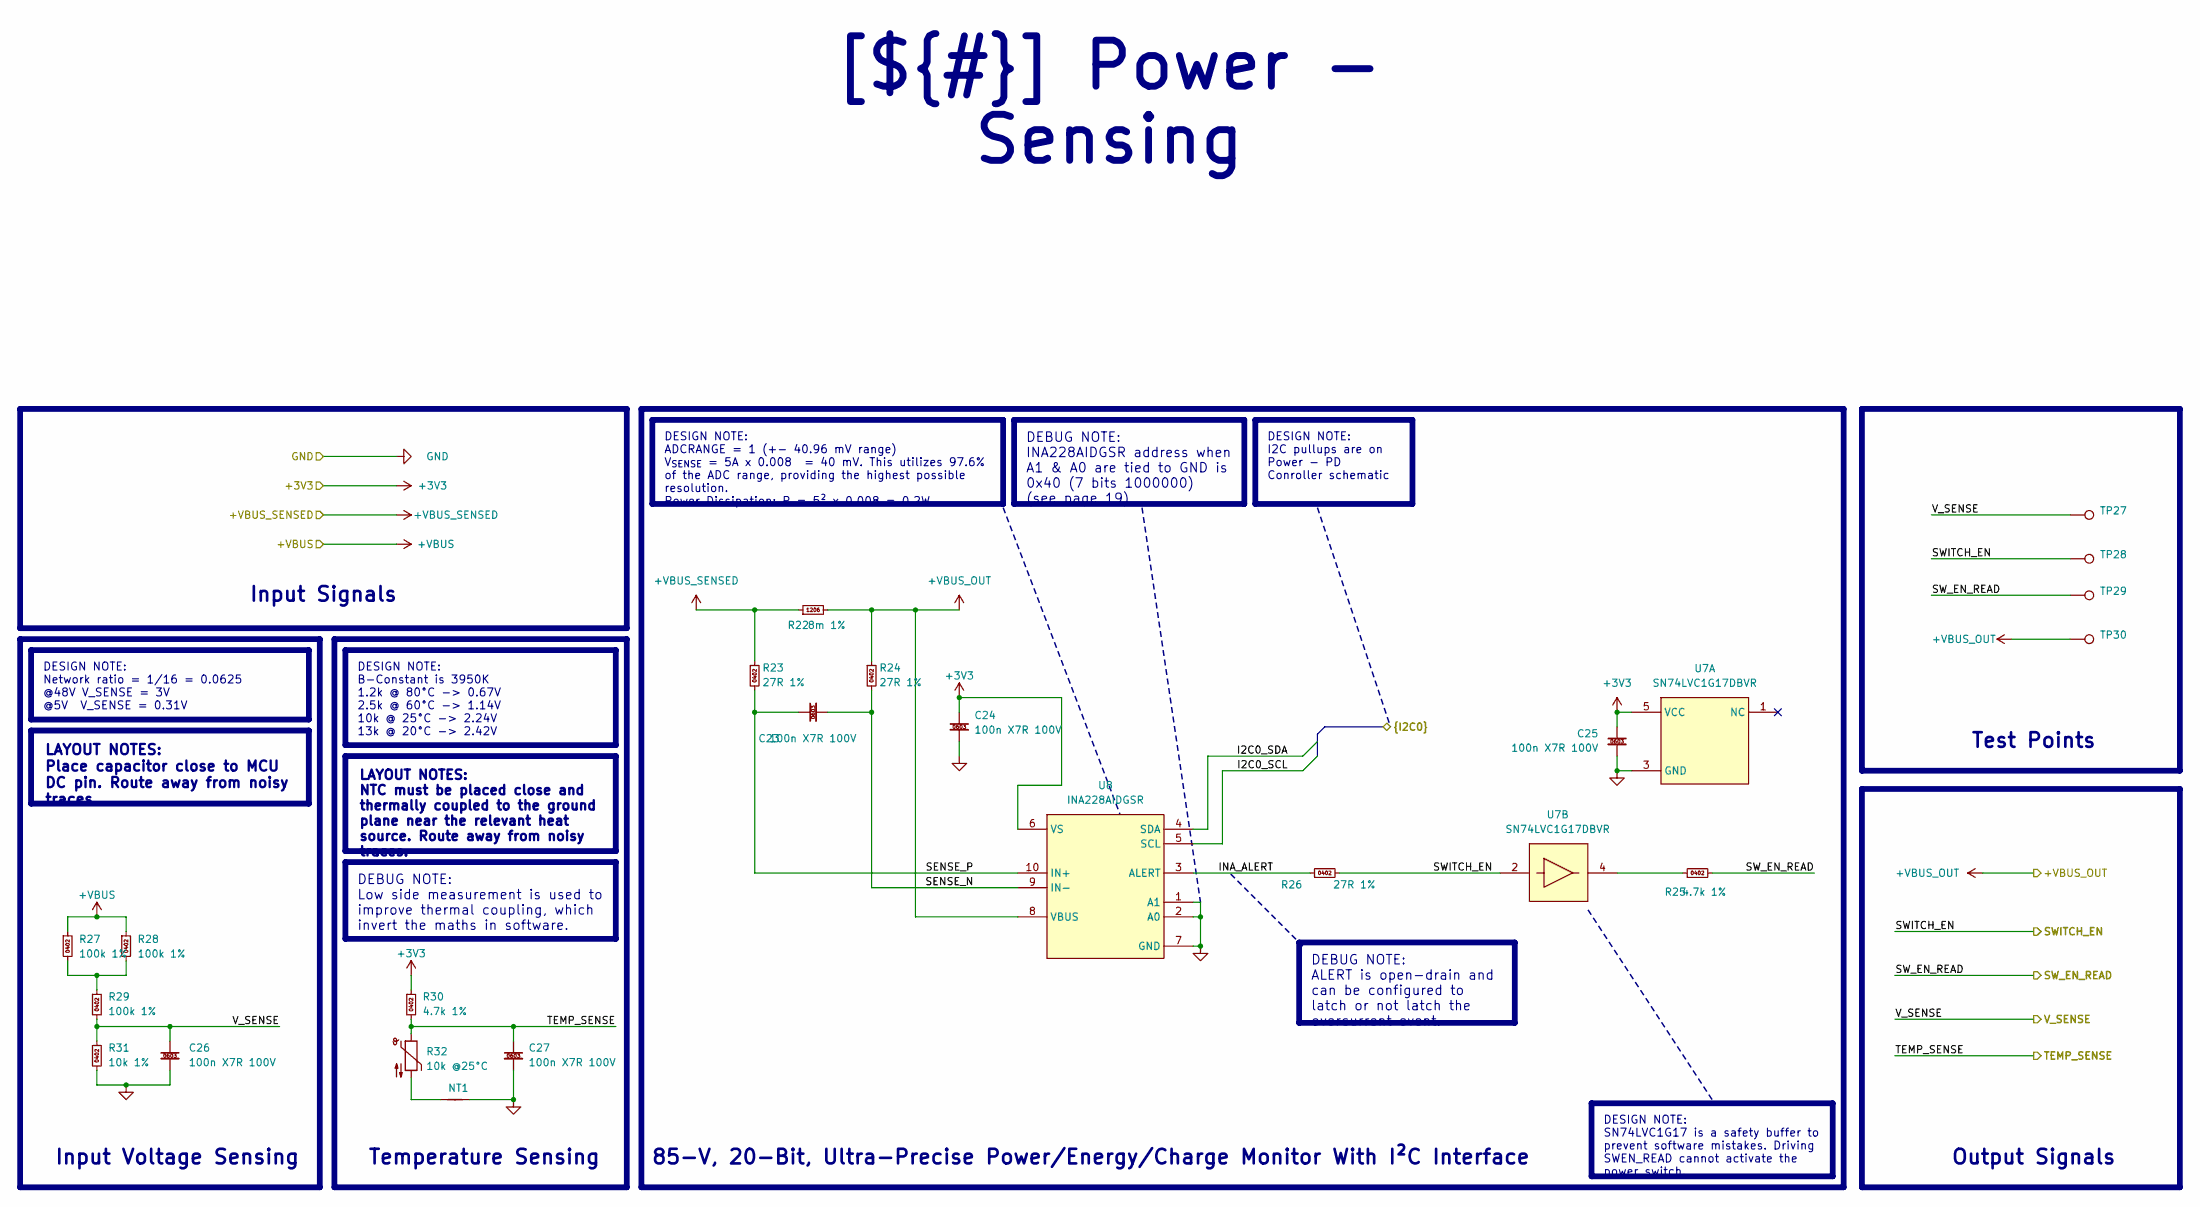
[picture p9: schematic power_sensing.kicad_sch, Power - Sensing]

Parts:
C23, C24, C25, C26, C27: 100n X7R 100V; capc_1608_09_l; Manufacturer Part Number CL10B104KC8NNNC; LCSC C15725
NT1: nt_2pad_20x20_20_60x20; NetTie-2_SMD_Pad0.5mm
R22: 8m 1%; WSLP1206_n_current_sense_6m_to_50m; Manufacturer Part Number HoLLR1206-1W-8mR-1%; LCSC C2988654
R23, R24, R26: 27R 1%; resc_1005_04_m; Manufacturer Part Number RC0402FR-0727RL; LCSC C138021
R25, R30: 4.7k 1%; resc_1005_04_m; Manufacturer Part Number 0402WGF4701TCE; LCSC C25900
R27, R28, R29: 100k 1%; resc_1005_04_m; Manufacturer Part Number 0402WGF1003TCE; LCSC C25741
R31: 10k 1%; resc_1005_04_n; Manufacturer Part Number 0402WGF1002TCE; LCSC C25744
R32: 10k @25°C; resc_1005_04_m; Manufacturer Part Number SDNT1005X103F3950FTF; LCSC C95939
TP27, TP28, TP29, TP30: tp_round_70
U7: SN74LVC1G17DBVR; sot25_95p_300x280x145_jedec_mo-178-aa_n; Manufacturer Part Number SN74LVC1G17DBVR; LCSC C7836
U8: INA228AIDGSR; vssop10_50p_300x300x110_mfg; Manufacturer Part Number INA228AIDGSR; LCSC C2887910

Connections:
+3V3: C24.1, C25.1, R30.1, U7.5 (VCC), U8.6 (VS); also elsewhere on the board
+VBUS: R27.1, R28.1; also elsewhere on the board
+VBUS_OUT: R22.2, R24.1, TP30.1 (1_1), U8.8 (VBUS); also elsewhere on the board
+VBUS_SENSED: R22.1, R23.1; also elsewhere on the board
/Project Architecture/MCU - Unit/I2C0_SCL: U8.5 (SCL); also elsewhere on the board
/Project Architecture/MCU - Unit/I2C0_SDA: U8.4 (SDA); also elsewhere on the board
/Project Architecture/MCU - Unit/SW_EN_READ: R25.2, TP29.1 (1_1); also elsewhere on the board
/Project Architecture/MCU - Unit/TEMP_SENSE: C27.1, R30.2, R32.1; also elsewhere on the board
/Project Architecture/MCU - Unit/V_SENSE: C26.1, R29.2, R31.1, TP27.1 (1_1); also elsewhere on the board
/Project Architecture/Power - PD Controller/SWITCH_EN: R26.2, TP28.1 (1_1), U7.2 (A); also elsewhere on the board
/Project Architecture/Power - Sensing/INA_ALERT: R26.1, U8.3 (ALERT)
/Project Architecture/Power - Sensing/SENSE_N: C23.2, R24.2, U8.9 (IN-)
/Project Architecture/Power - Sensing/SENSE_P: C23.1, R23.2, U8.10 (IN+)
GND: C24.2, C25.2, C26.2, C27.2, NT1.2, R31.2, U7.3 (GND), U8.1 (A1), U8.2 (A0), U8.7 (GND); also elsewhere on the board
unnamed: NT1.1, R32.2
unnamed: R27.2, R28.2, R29.1
unnamed: R25.1, U7.4 (Y)

Notes on the sheet:
Test Points
Input Signals
85-V, 20-Bit, Ultra-Precise Power/Energy/Charge Monitor With I²C Interface
Temperature Sensing
Output Signals
Input Voltage Sensing
DESIGN NOTE: B-Constant is 3950K 1.2k @ 80°C -> 0.67V 2.5k @ 60°C -> 1.14V 10k @ 25°C -> 2.24V 13k @ 20°C -> 2.42V
DESIGN NOTE: I2C pullups are on Power - PD Conroller schematic
DEBUG NOTE: INA228AIDGSR address when A1 & A0 are tied to GND is 0x40 (7 bits 1000000) (see page 19)
DESIGN NOTE: ADCRANGE = 1 (+- 40.96 mV range) V_{SENSE} = 5A x 0.008 = 40 mV. This utilizes 97.6% of the ADC range, providing the highest possible resolution. Power Dissipation: P = 5² x 0.008 = 0.2W
LAYOUT NOTES: NTC must be placed close and thermally coupled to the ground plane near the relevant heat source. Route away from noisy traces.
LAYOUT NOTES: Place capacitor close to MCU DC pin. Route away from noisy traces.
[${#}] ${TITLE}
DEBUG NOTE: Low side measurement is used to improve thermal coupling, which invert the maths in software.
DESIGN NOTE: Network ratio = 1/16 = 0.0625 @48V V_SENSE = 3V @5V V_SENSE = 0.31V
DEBUG NOTE: ALERT is open-drain and can be configured to latch or not latch the overcurrent event.
DESIGN NOTE: SN74LVC1G17 is a safety buffer to prevent software mistakes. Driving SWEN_READ cannot activate the power switch.

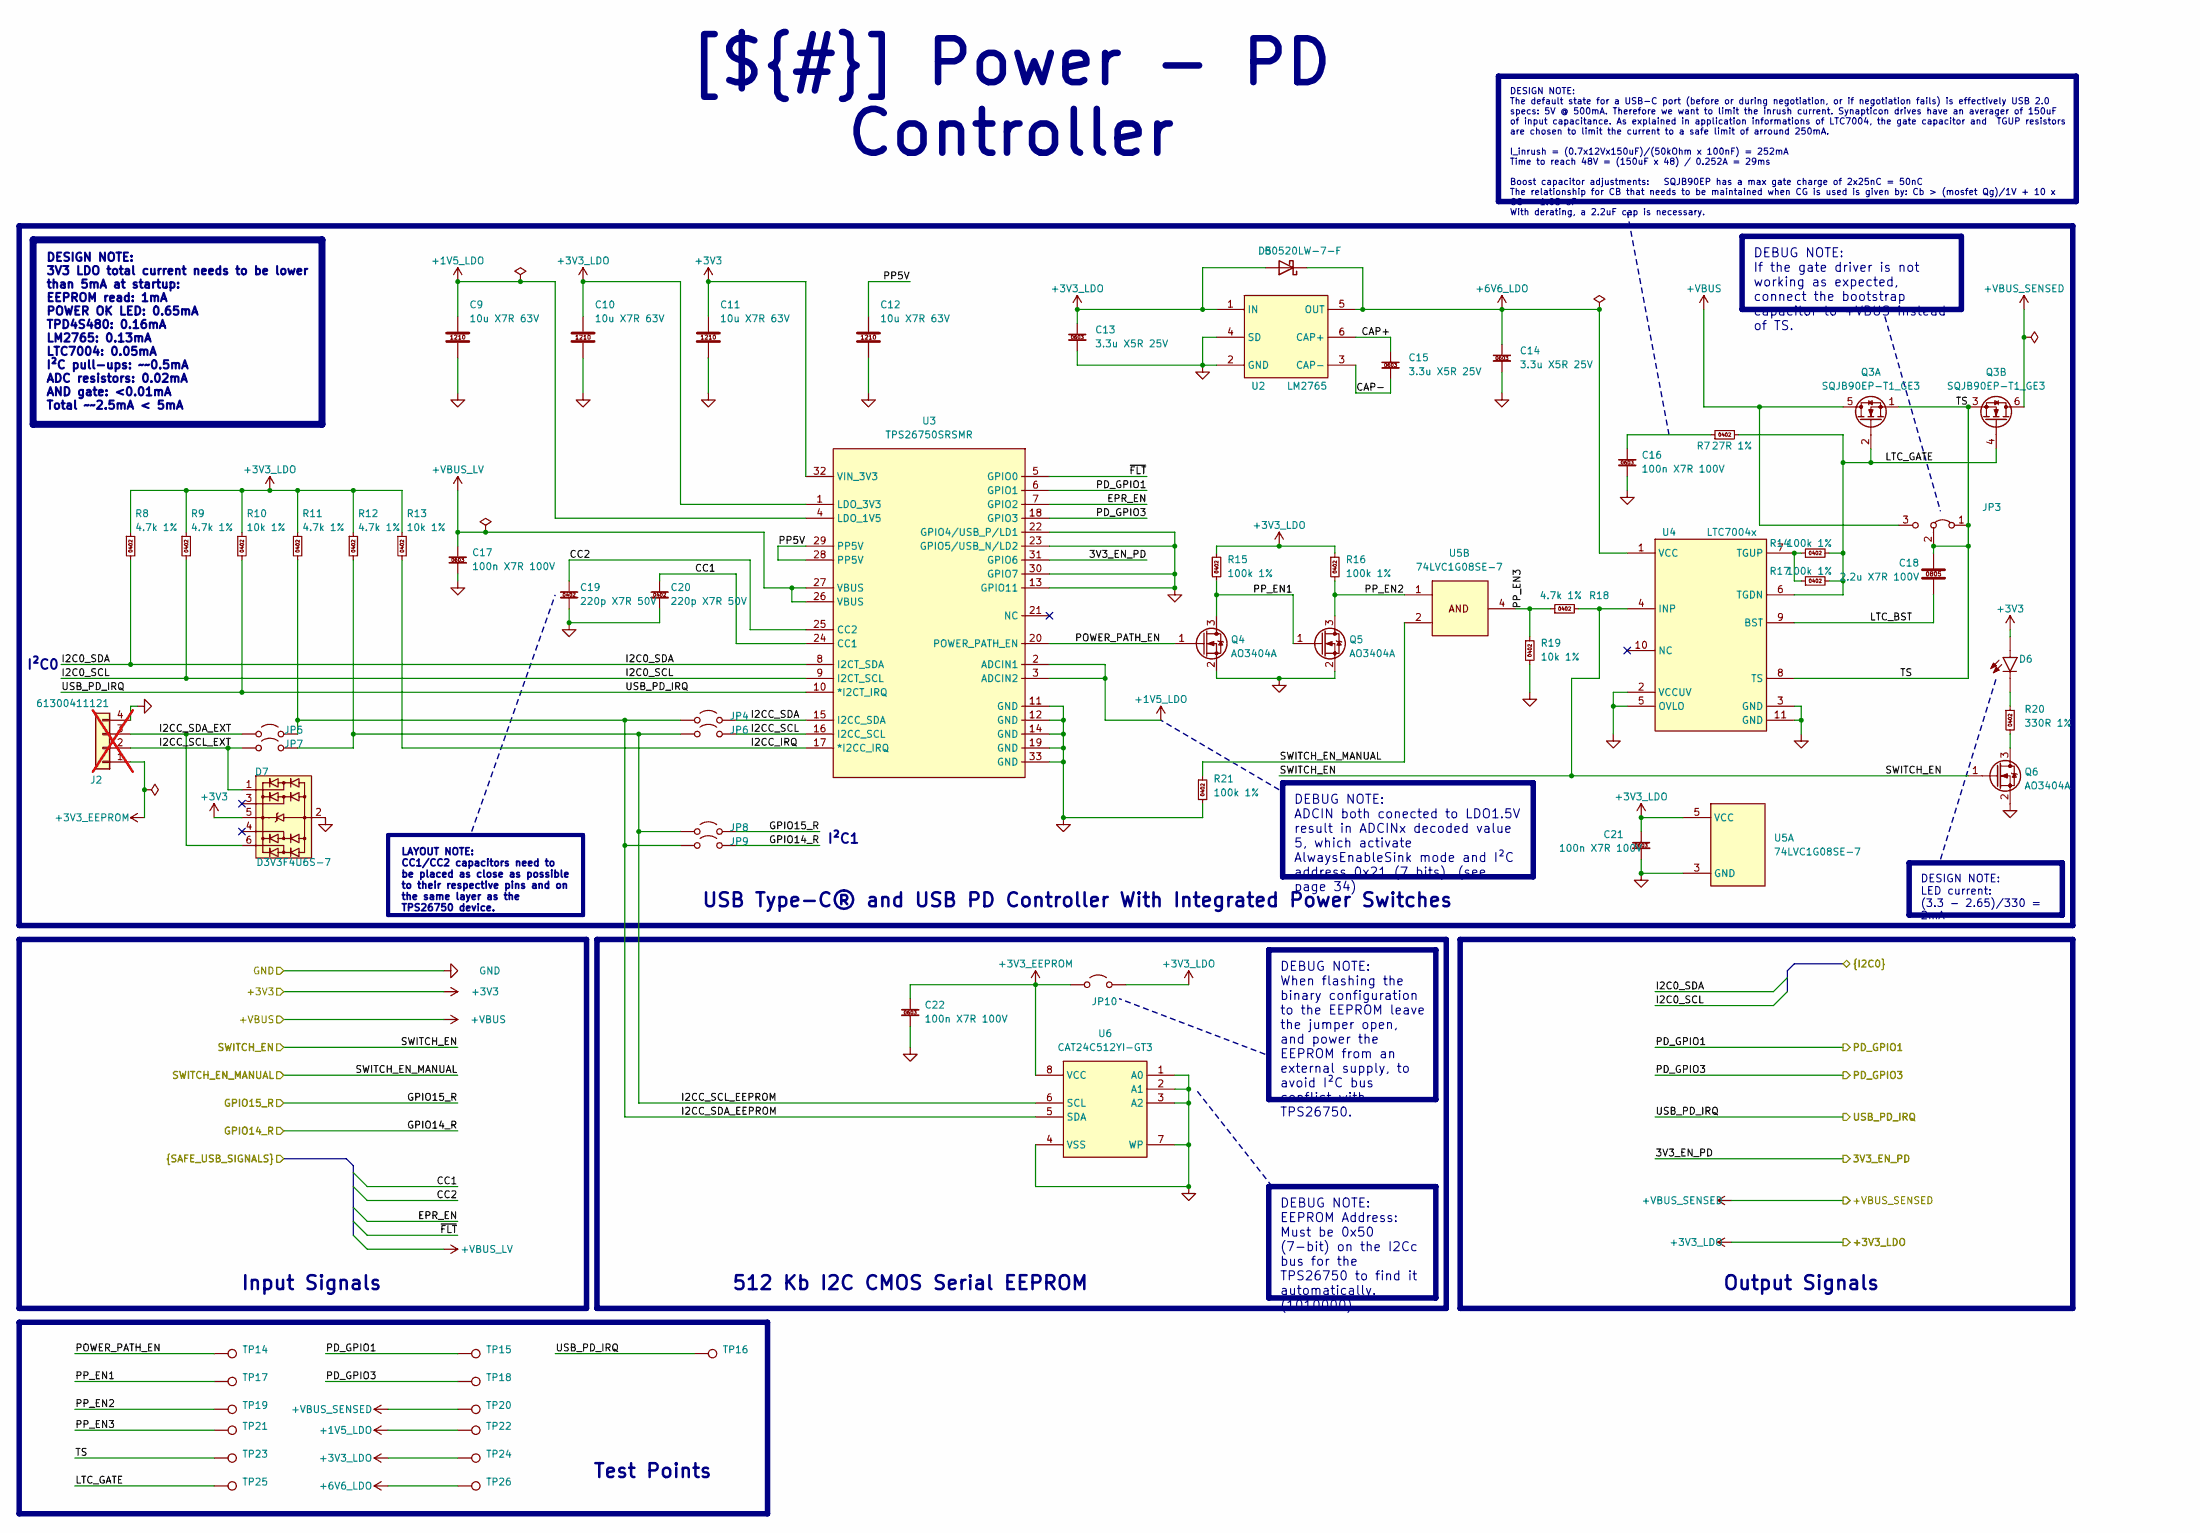
[picture p10: schematic power_pd_controller.kicad_sch, Power - PD Controller]

Parts:
C9, C10, C11, C12: 10u X7R 63V; capc_3225_27_n; Manufacturer Part Number GRM32ER71J106KA12L; LCSC C437568
C13, C14, C15: 3.3u X5R 25V; capc_1608_09_n; Manufacturer Part Number TCC0603X5R335M250CT; LCSC C5360803
C16, C17, C21, C22: 100n X7R 100V; capc_1608_09_l; Manufacturer Part Number CL10B104KC8NNNC; LCSC C15725
C18: 2.2u X7R 100V; capc_2012_14_m; Manufacturer Part Number HHV0805R7225K101NSLJ; LCSC C22367838
C19, C20: 220p X7R 50V; capc_1005_06_l; Manufacturer Part Number CL05B221KB5NNNC; LCSC C296710
D5: B0520LW-7-F; sod-123_270x155135_n; Manufacturer Part Number B0520LW-7-F; LCSC C155367
D6: APTD1608LQBC/D; kingbright_0603_blue; Manufacturer Part Number APTD1608LQBC/D; LCSC C5344742
D7: D3V3F4U6S-7; sot363_sc88_65p_200x125x110_n; Manufacturer Part Number D3V3F4U6S-7; LCSC C1869321
J2: 61300411121; we_61300411121; Manufacturer Part Number 61300411121; LCSC C5184785; not fitted
JP3: jumper_solder_3pad_12nc_kicad; SolderJumper-3_P1.3mm_Bridged2Bar12_RoundedPad1.0x1.5mm
JP4, JP5, JP6, JP7, JP8, JP9: jumper_solder_2pad_no; jumper_solder_2pad_no_40x40_20
JP10: jumper_solder_2pad_no_kicad; SolderJumper-2_P1.3mm_Open_RoundedPad1.0x1.5mm
Q3: SQJB90EP-T1_GE3; PowerPAKSO-8_127p_513x615x120_n; Manufacturer Part Number SQJB90EP-T1_GE3; LCSC C727731
Q4, Q5, Q6: AO3404A; sot-23-3L_103p_300x130x110_n; Manufacturer Part Number AO3404A; LCSC C30010
R7: 27R 1%; resc_1005_04_m; Manufacturer Part Number RC0402FR-0727RL; LCSC C138021
R8, R9, R11, R12, R18: 4.7k 1%; resc_1005_04_m; Manufacturer Part Number 0402WGF4701TCE; LCSC C25900
R10, R13, R19: 10k 1%; resc_1005_04_n; Manufacturer Part Number 0402WGF1002TCE; LCSC C25744
R14, R15, R16, R17, R21: 100k 1%; resc_1005_04_m; Manufacturer Part Number 0402WGF1003TCE; LCSC C25741
R20: 330R 1%; resc_1005_04_m; Manufacturer Part Number 0402WGF3300TCE; LCSC C25104
TP14, TP15, TP16, TP17, TP18, TP19, TP20, TP21, TP22, TP23, TP24, TP25, TP26: tp_round_70
U2: LM2765; sot236_p95_290x160x110_n; Manufacturer Part Number LM2765M6X/NOPB; LCSC C140270
U3: TPS26750SRSMR; qfn32_40p_400x400x100_tp_280x280_mfg; Manufacturer Part Number TPS26750SRSMR; LCSC C42166327
U4: LTC7004x; msop_10p_300x490x110_tp168x188_n; Manufacturer Part Number LTC7004EMSE#TRPBF; LCSC C690106
U5: 74LVC1G08SE-7; sot353_65p_200x125x110_mo-203-aa_n; Manufacturer Part Number 74LVC1G08SE-7; LCSC C460522
U6: CAT24C512YI-GT3; JEDEC_MO-153_AA; Manufacturer Part Number CAT24C512YI-GT3; LCSC C56096

Connections:
+1V5_LDO: C9.1, TP22.1 (1_1), U3.2 (ADCIN1), U3.3 (ADCIN2), U3.4 (LDO_1V5)
+3V3: C11.1, D6.2 (A), D7.5, U3.32 (VIN_3V3); also elsewhere on the board
+3V3_EEPROM: C22.1, J2.1, JP10.1 (A), U6.8 (VCC)
+3V3_LDO: C10.1, C13.1, C21.1, D5.2 (A), JP10.2 (B), R8.1, R9.1, R10.1, R11.1, R12.1, R13.1, R15.1, R16.1, TP24.1 (1_1), U2.1 (IN), U3.1 (LDO_3V3), U5.5 (VCC); also elsewhere on the board
+6V6_LDO: C14.1, D5.1 (K), TP26.1 (1_1), U2.5 (OUT), U4.1 (VCC)
+VBUS: JP3.3 (B), Q3.5 (D); also elsewhere on the board
+VBUS_LV: C17.1, U3.26 (VBUS), U3.27 (VBUS); also elsewhere on the board
+VBUS_SENSED: Q3.6 (D), TP20.1 (1_1); also elsewhere on the board
/Project Architecture/MCU - Unit/GPIO14_R: JP9.2 (B); also elsewhere on the board
/Project Architecture/MCU - Unit/GPIO15_R: JP8.2 (B); also elsewhere on the board
/Project Architecture/MCU - Unit/I2C0_SCL: R9.2, U3.9 (I2CT_SCL); also elsewhere on the board
/Project Architecture/MCU - Unit/I2C0_SDA: R8.2, U3.8 (I2CT_SDA); also elsewhere on the board
/Project Architecture/MCU - Unit/PD_GPIO1: TP15.1 (1_1), U3.6 (GPIO1); also elsewhere on the board
/Project Architecture/MCU - Unit/PD_GPIO3: TP18.1 (1_1), U3.18 (GPIO3); also elsewhere on the board
/Project Architecture/MCU - Unit/SWITCH_EN_MANUAL: R21.1, U5.2 (B); also elsewhere on the board
/Project Architecture/MCU - Unit/USB_PD_IRQ: R10.2, TP16.1 (1_1), U3.10 (*I2CT_IRQ); also elsewhere on the board
/Project Architecture/Power - Generation/3V3_EN_PD: U3.31 (GPIO6); also elsewhere on the board
/Project Architecture/Power - PD Controller/CAP+: C15.1, U2.6 (CAP+)
/Project Architecture/Power - PD Controller/CAP-: C15.2, U2.3 (CAP-)
/Project Architecture/Power - PD Controller/CC1: C20.1, U3.24 (CC1); also elsewhere on the board
/Project Architecture/Power - PD Controller/CC2: C19.1, U3.25 (CC2); also elsewhere on the board
/Project Architecture/Power - PD Controller/EPR_EN: U3.7 (GPIO2); also elsewhere on the board
/Project Architecture/Power - PD Controller/I2CC_IRQ: R13.2, U3.17 (*I2CC_IRQ)
/Project Architecture/Power - PD Controller/I2CC_SCL: JP6.2 (B), U3.16 (I2CC_SCL)
/Project Architecture/Power - PD Controller/I2CC_SCL_EEPROM: JP6.1 (A), JP7.2 (B), JP8.1 (A), R12.2, U6.6 (SCL)
/Project Architecture/Power - PD Controller/I2CC_SCL_EXT: D7.1, J2.2, JP7.1 (A)
/Project Architecture/Power - PD Controller/I2CC_SDA: JP4.2 (B), U3.15 (I2CC_SDA)
/Project Architecture/Power - PD Controller/I2CC_SDA_EEPROM: JP4.1 (A), JP5.2 (B), JP9.1 (A), R11.2, U6.5 (SDA)
/Project Architecture/Power - PD Controller/I2CC_SDA_EXT: D7.6, J2.3, JP5.1 (A)
/Project Architecture/Power - PD Controller/LTC_BST: C18.2, U4.9 (BST)
/Project Architecture/Power - PD Controller/LTC_GATE: Q3.2 (G), Q3.4 (G), R7.2, R14.2, R17.2, TP25.1 (1_1), U4.6 (TGDN)
/Project Architecture/Power - PD Controller/POWER_PATH_EN: Q4.1 (G), TP14.1 (1_1), U3.20 (POWER_PATH_EN)
/Project Architecture/Power - PD Controller/PP5V: C12.1, U3.28 (PP5V), U3.29 (PP5V)
/Project Architecture/Power - PD Controller/PP_EN1: Q4.3 (D), Q5.1 (G), R15.2, TP17.1 (1_1)
/Project Architecture/Power - PD Controller/PP_EN2: Q5.3 (D), R16.2, TP19.1 (1_1), U5.1 (A)
/Project Architecture/Power - PD Controller/PP_EN3: R18.1, R19.1, TP21.1 (1_1), U5.4 (Y)
/Project Architecture/Power - PD Controller/SWITCH_EN: Q6.1 (G), R18.2, U4.4 (INP); also elsewhere on the board
/Project Architecture/Power - PD Controller/TS: C18.1, JP3.1 (A), JP3.2 (C), Q3.1 (S), Q3.3 (S), TP23.1 (1_1), U4.8 (TS)
/Project Architecture/Power - PD Controller/~FLT: U3.5 (GPIO0); also elsewhere on the board
GND: C9.2, C10.2, C11.2, C12.2, C13.2, C14.2, C16.2, C17.2, C19.2, C20.2, C21.2, C22.2, D7.2, J2.4, Q4.2 (S), Q5.2 (S), Q6.2 (S), R19.2, R21.2, U2.2 (GND), U2.4 (SD), U3.11 (GND), U3.12 (GND), U3.13 (GPIO11), U3.14 (GND), U3.19 (GND), U3.22 (GPIO4/USB_P/LD1), U3.23 (GPIO5/USB_N/LD2), U3.30 (GPIO7), U3.33 (GND), U4.2 (VCCUV), U4.3 (GND), U4.5 (OVLO), U4.11 (GND), U5.3 (GND), U6.1 (A0), U6.2 (A1), U6.3 (A2), U6.4 (VSS), U6.7 (WP); also elsewhere on the board
unnamed: C16.1, R7.1
unnamed: D6.1 (C), R20.1
unnamed: Q6.3 (D), R20.2
unnamed: R14.1, R17.1, U4.7 (TGUP)

Notes on the sheet:
I²C0
512 Kb I2C CMOS Serial EEPROM
USB Type-C® and USB PD Controller With Integrated Power Switches
Output Signals
Test Points
Input Signals
I²C1
DEBUG NOTE: ADCIN both conected to LDO1.5V result in ADCINx decoded value 5, which activate AlwaysEnableSink mode and I²C address 0x21 (7 bits). (see page 34)
DEBUG NOTE: EEPROM Address: Must be 0x50 (7-bit) on the I2Cc bus for the TPS26750 to find it automatically. (1010000)
DEBUG NOTE: If the gate driver is not working as expected, connect the bootstrap capacitor to +VBUS instead of TS.
LAYOUT NOTE: CC1/CC2 capacitors need to be placed as close as possible to their respective pins and on the same layer as the TPS26750 device.
DESIGN NOTE: 3V3 LDO total current needs to be lower than 5mA at startup: EEPROM read: 1mA POWER OK LED: 0.65mA TPD4S480: 0.16mA LM2765: 0.13mA LTC7004: 0.05mA I²C pull-ups: ~~0.5mA ADC resistors: 0.02mA AND gate: <0.01mA Total ~~2.5mA < 5mA
DESIGN NOTE: The default state for a USB-C port (before or during negotiation, or if negotiation fails) is effectively USB 2.0 specs: 5V @ 500mA. Therefore we want to limit the inrush current. Synapticon drives have an averager of 150uF of input capacitance. As explained in application informations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
DESIGN NOTE: LED current: (3.3 - 2.65)/330 = 2mA
DEBUG NOTE: When flashing the binary configuration to the EEPROM leave the jumper open, and power the EEPROM from an external supply, to avoid I²C bus conflict with TPS26750.
[${#}] ${TITLE}

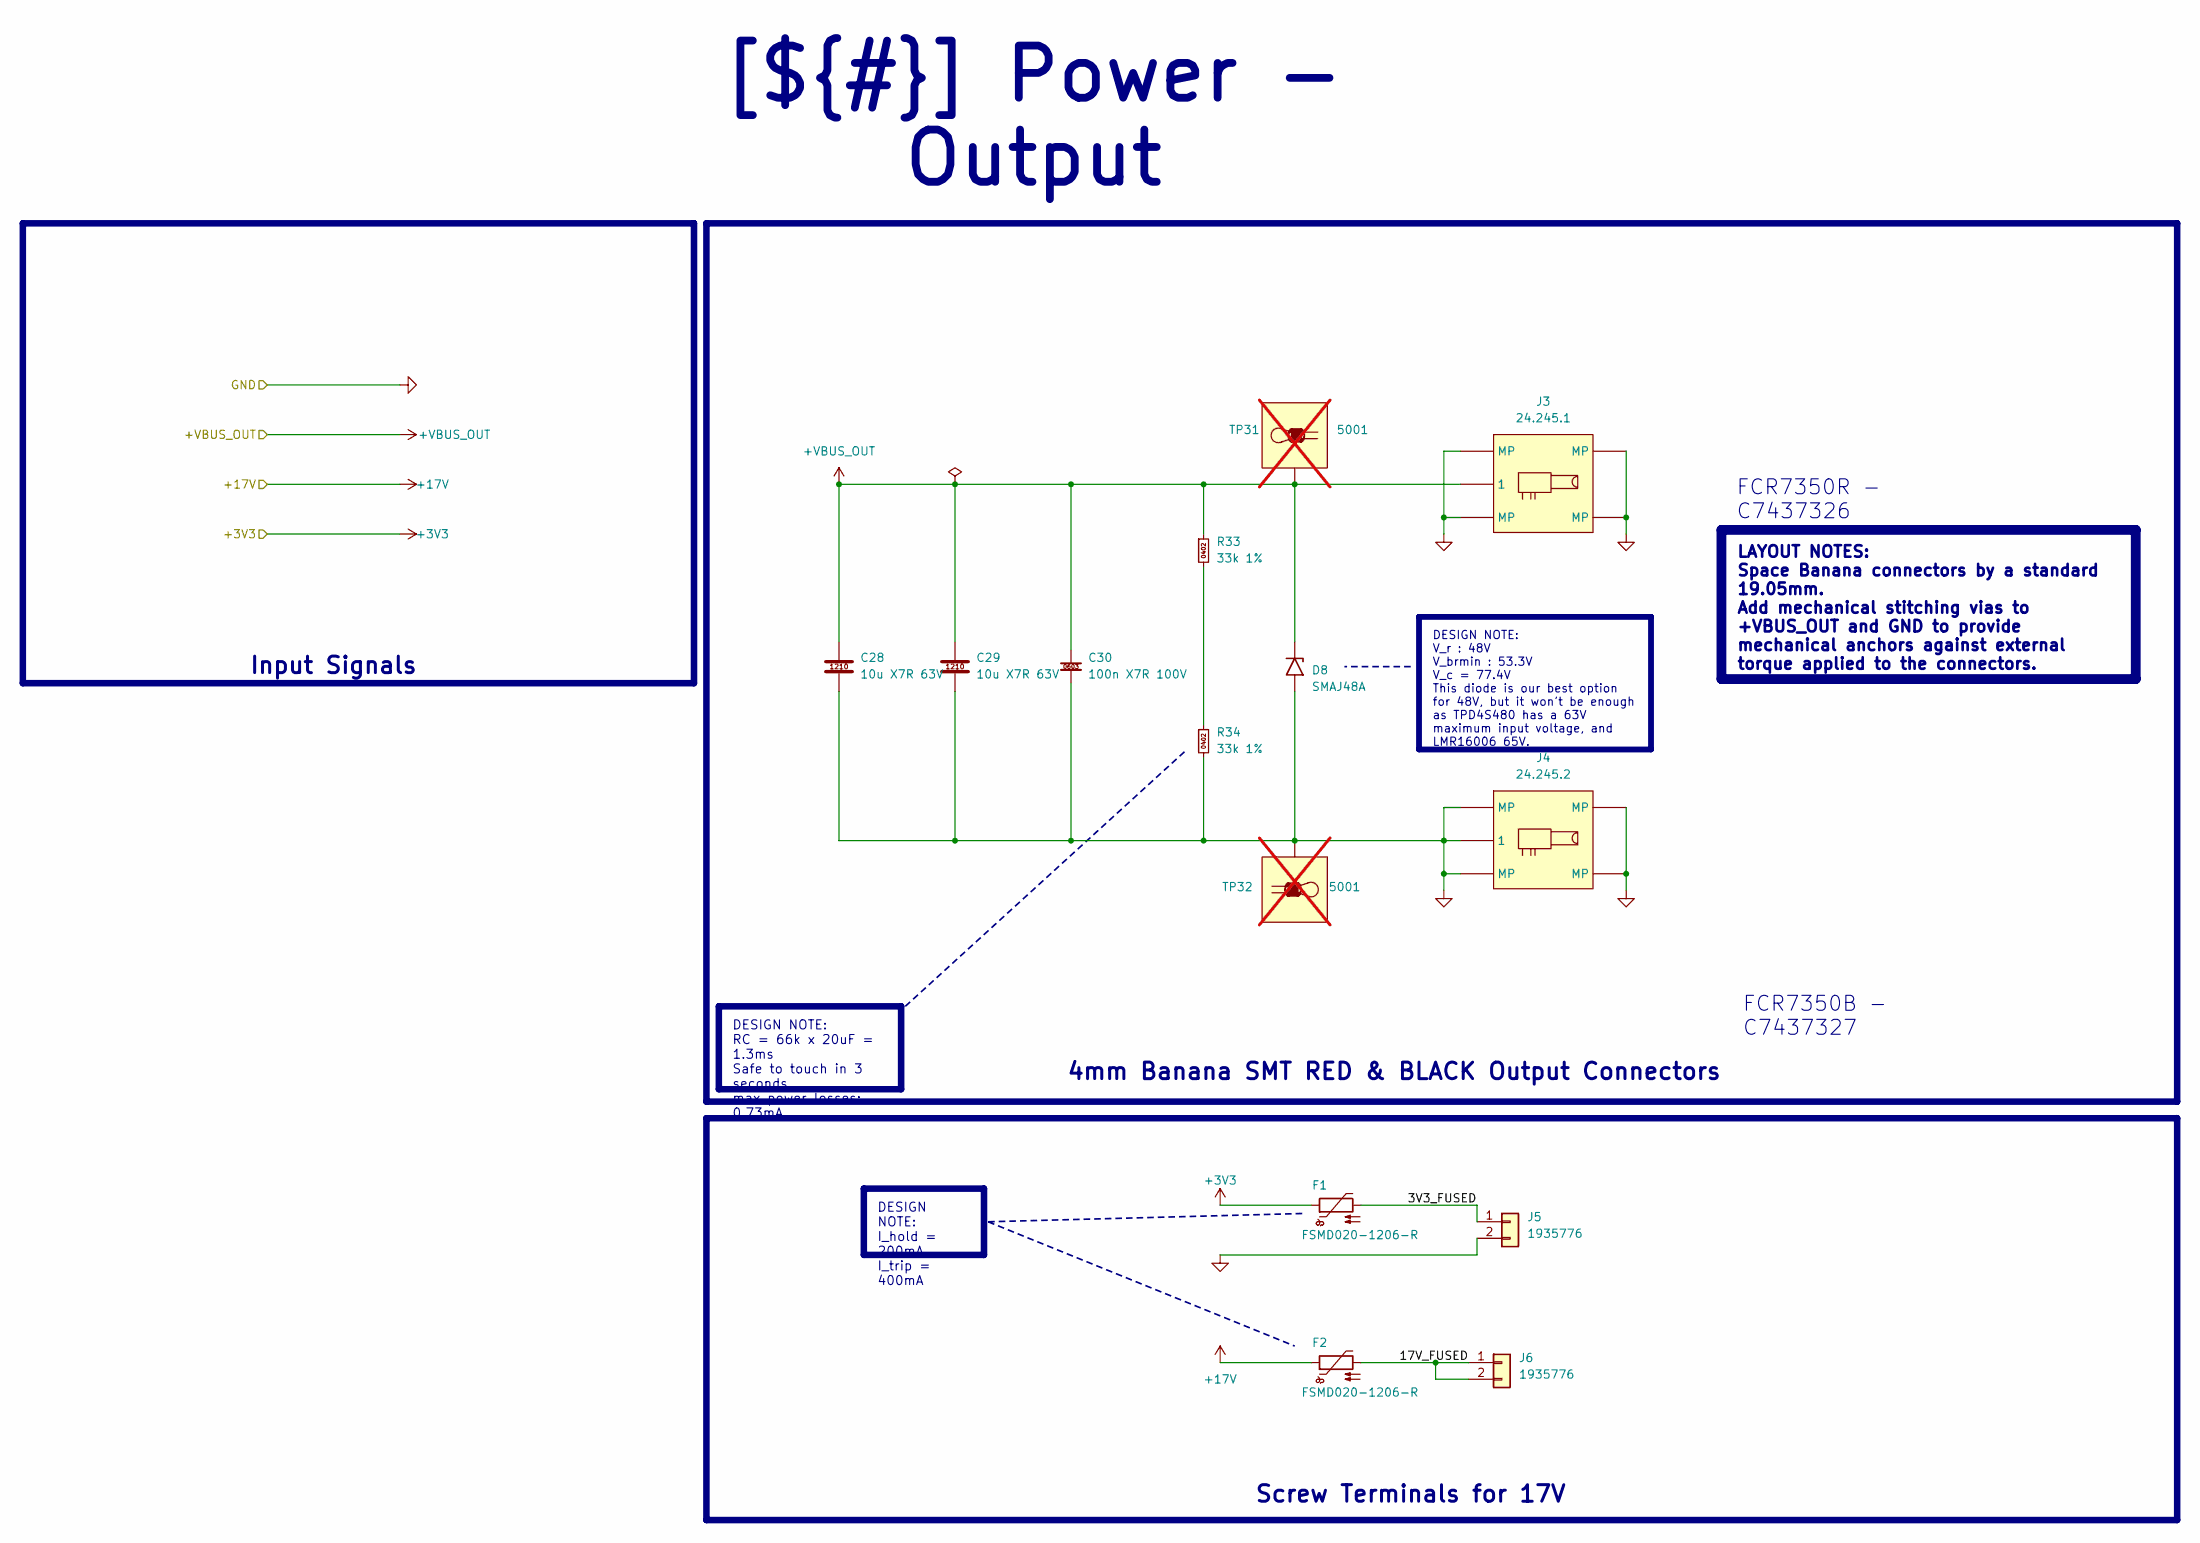
[picture p11: schematic power_output.kicad_sch, Power - Output]

Parts:
C28, C29: 10u X7R 63V; capc_3225_27_n; Manufacturer Part Number GRM32ER71J106KA12L; LCSC C437568
C30: 100n X7R 100V; capc_1608_09_l; Manufacturer Part Number CL10B104KC8NNNC; LCSC C15725
D8: SMAJ48A; do-214ac_440p_430x250x230_n_p; Manufacturer Part Number SMAJ48A; LCSC C41376401
F1, F2: FSMD020-1206-R; ptc_1206_08_n; Manufacturer Part Number FSMD020-1206-R; LCSC C220145
J3: 24.245.1; fcr7350r; Manufacturer Part Number 24.245.1; LCSC C7437326
J4: 24.245.2; fcr7350b; Manufacturer Part Number 24.245.2; LCSC C7437327
J5, J6: 1935776; phoenix_1935776; Manufacturer Part Number 1935776; LCSC C3817389
R33, R34: 33k 1%; resc_1005_04_n; Manufacturer Part Number RC0402FR-0733KL; LCSC C138003
TP31, TP32: 5001; Manufacturer Part Number 5001; LCSC C238122; not fitted

Connections:
+3V3: F1.1; also elsewhere on the board
+17V: F2.1; also elsewhere on the board
+VBUS_OUT: C28.1, C29.1, C30.1, D8.1 (A1), J3.1, R33.1, TP31.1 (1_1); also elsewhere on the board
/Project Architecture/Power - Output/3V3_FUSED: F1.2, J5.1
/Project Architecture/Power - Output/17V_FUSED: F2.2, J6.1, J6.2
GND: C28.2, C29.2, C30.2, D8.2 (A2), J3.MP1 (MP), J3.MP2 (MP), J3.MP3 (MP), J3.MP4 (MP), J4.1, J4.MP1 (MP), J4.MP2 (MP), J4.MP3 (MP), J4.MP4 (MP), J5.2, R34.2, TP32.1 (1_1); also elsewhere on the board
unnamed: R33.2, R34.1

Notes on the sheet:
Screw Terminals for 17V
4mm Banana SMT RED & BLACK Output Connectors
Input Signals
DESIGN NOTE: V_r : 48V V_brmin : 53.3V V_c = 77.4V This diode is our best option for 48V, but it won't be enough as TPD4S480 has a 63V maximum input voltage, and LMR16006 65V.
DESIGN NOTE: RC = 66k x 20uF = 1.3ms Safe to touch in 3 seconds max power losses: 0.73mA
[${#}] ${TITLE}
DESIGN NOTE: I_hold = 200mA I_trip = 400mA
FCR7350R - C7437326
LAYOUT NOTES: Space Banana connectors by a standard 19.05mm. Add mechanical stitching vias to +VBUS_OUT and GND to provide mechanical anchors against external torque applied to the connectors.
FCR7350B - C7437327
