patrickstreit/PD240W/src/config/app_config.h

#pragma once

#include <cstdint>

// ============================================================================
// Application Configuration Constants
// ============================================================================

namespace AppConfig {
    // -------------------------------------------------------------------------
    // Timing Constants
    // -------------------------------------------------------------------------
    constexpr uint32_t BOOT_DURATION_MS = 2000;        // Boot screen max duration [ms]
    constexpr uint32_t BOOT_MIN_DISPLAY_MS = 500;      // Minimum boot screen time [ms]
    constexpr uint32_t BOOT_READY_DELAY_MS = 300;      // Time to show "Ready!" before transition [ms]
    constexpr uint32_t MENU_TIMEOUT_MS = 20000;        // Auto-return from menu [ms]
    constexpr uint32_t DISPLAY_UPDATE_MS = 100;        // Main screen refresh rate [ms]
    constexpr uint32_t ENCODER_LONG_PRESS_MS = 300;    // Long press threshold [ms]
    constexpr uint32_t ENCODER_MIN_PRESS_MS = 30;      // Minimum press time for debounce [ms]

    // Hardware watchdog: reboots the MCU if the main loop stops feeding it (e.g. a
    // stuck I2C bus hangs safety/PD monitoring with the load switch possibly on).
    // Sized above the longest legitimate blocking window: the boot PD-config push's
    // waitCommandClear (CMD_CLEAR_TIMEOUT_MS = 3000 ms). The push loop feeds the
    // watchdog between steps so only a single hung step needs to fit this budget.
    constexpr uint32_t WATCHDOG_TIMEOUT_MS = 4000;     // Main-loop watchdog timeout [ms]

    // -------------------------------------------------------------------------
    // Boot Timing
    // -------------------------------------------------------------------------
    constexpr uint32_t BOOT_PDO_TIMEOUT_MS = 800;               // PDO discovery timeout during boot [ms]
    constexpr uint32_t BOOT_NEGOTIATION_TIMEOUT_MS = 1000;      // Contract negotiation timeout during boot [ms]
    constexpr uint32_t BOOT_EPR_POLL_INTERVAL_MS = 150;         // EPR PDO poll interval during boot [ms]
    constexpr uint32_t BOOT_EPR_TIMEOUT_MS = 600;               // Non-EPR charger EPR probe timeout [ms]
    constexpr uint32_t BOOT_EPR_CONTRACT_TIMEOUT_MS = 1200;     // EPR contract settlement timeout [ms]
    constexpr uint32_t BOOT_PENDING_CONTRACT_TIMEOUT_MS = 5000; // Max total boot time while waiting for delayed startup contract [ms]

    // -------------------------------------------------------------------------
    // Safety Thresholds
    // -------------------------------------------------------------------------
    constexpr uint8_t TEMP_CAUTION_C = 50;             // Temperature hot threshold [C]
    constexpr uint8_t TEMP_WARNING_C = 65;             // Temperature warning threshold [C]
    constexpr uint8_t TEMP_CRITICAL_WARNING_C = 75;    // Temperature critical warning threshold [C]
    constexpr uint8_t TEMP_SHUTDOWN_C = 80;            // Temperature shutdown threshold [C]
    constexpr uint32_t MIN_VBUS_FOR_17V_MV = 7000;     // Minimum VBUS for aux buck enable [mV] (aux buck reworked from 17V to 5V)

    // -------------------------------------------------------------------------
    // Current Limit Settings
    // -------------------------------------------------------------------------
    constexpr uint32_t CURRENT_LIMIT_MIN_MA = 10;           // Minimum current limit [mA] (0.01A)
    constexpr uint32_t CURRENT_LIMIT_MAX_MA = 5000;         // Maximum current limit [mA]
    constexpr uint32_t CURRENT_LIMIT_NON_PD_MAX_MA = 3000;  // Max for non-PD chargers (USB BC1.2)
    constexpr uint32_t CURRENT_LIMIT_STEP_MA = 10;          // Base adjustment step [mA] (fine control)
    constexpr uint32_t CURRENT_LIMIT_DEFAULT_MA = 1000;     // Default current limit [mA]
    constexpr uint32_t STARTUP_REQUEST_MIN_MA = 500;        // Floor for pre-boot contract request current [mA]
    constexpr uint32_t CURRENT_LIMIT_VELOCITY_DIV = 1;      // Velocity divider (1 = use full velocity scaling)

    // -------------------------------------------------------------------------
    // PPS Voltage Settings
    // -------------------------------------------------------------------------
    constexpr uint32_t PPS_VOLTAGE_STEP_MV = 20;        // PPS voltage step size [mV] (PD spec minimum)
    constexpr uint32_t PPS_VELOCITY_MULT = 1;           // Keep single-detent PPS moves at the 20mV spec minimum
    constexpr uint32_t PPS_VOLTAGE_FLOOR_MV = 3300;     // CC fallback floor when the active APDO range min is unknown

    // -------------------------------------------------------------------------
    // AVS Voltage Settings
    // -------------------------------------------------------------------------
    constexpr uint32_t AVS_VOLTAGE_STEP_MV = 100;        // AVS voltage step size [mV] (PD spec EPR minimum)
    constexpr uint32_t AVS_VELOCITY_MULT = 1;            // No extra multiplier (100mV base step)
    constexpr uint32_t AVS_VOLTAGE_FLOOR_MV = 15000;     // CC fallback floor when the active APDO range min is unknown

    // -------------------------------------------------------------------------
    // Display Settings
    // -------------------------------------------------------------------------
    constexpr uint8_t LCD_BRIGHTNESS_DEFAULT = 100;    // Default brightness (%)
    constexpr uint8_t LCD_BRIGHTNESS_MIN = 5;          // Minimum brightness (%)
    constexpr uint8_t LCD_BRIGHTNESS_MAX = 100;        // Maximum brightness (%)
    constexpr uint8_t LCD_BRIGHTNESS_STEP = 5;         // Brightness adjustment step (%)
    constexpr uint8_t LCD_BRIGHTNESS_DIM = 5;          // Dimmed brightness (%)
    constexpr uint16_t LCD_WIDTH = 240;
    constexpr uint16_t LCD_HEIGHT = 320;

    // -------------------------------------------------------------------------
    // Settings Limits
    // -------------------------------------------------------------------------
    constexpr uint8_t AUTO_DIM_MIN_MINUTES = 0;        // Minimum dim timeout [min], 0 = OFF
    constexpr uint8_t AUTO_DIM_MAX_MINUTES = 10;       // Maximum dim timeout [min]
    constexpr uint8_t STARTUP_MELODY_MAX = 3;          // Max melody index (0=Silent..3=TwoTone)
    constexpr uint8_t STARTUP_CONTRACT_MODE_MAX = 2;   // Max contract mode (0=Lowest..2=LastUsed)

    // -------------------------------------------------------------------------
    // Buzzer Tones
    // -------------------------------------------------------------------------
    constexpr uint16_t BEEP_NAV_FREQ = 800;            // Navigation beep frequency [Hz]
    constexpr uint16_t BEEP_NAV_DURATION = 20;         // Navigation beep duration [ms]
    constexpr uint16_t BEEP_SELECT_FREQ = 1400;        // Select/confirm beep frequency [Hz]
    constexpr uint16_t BEEP_SELECT_DURATION = 30;      // Select/confirm beep duration [ms]
    constexpr uint16_t BEEP_EXIT_FREQ = 1000;          // Exit/back beep frequency [Hz]
    constexpr uint16_t BEEP_EXIT_DURATION = 30;        // Exit/back beep duration [ms]
    constexpr uint16_t BEEP_CONFIRM_FREQ = 1000;       // Confirm action beep frequency [Hz]
    constexpr uint16_t BEEP_CONFIRM_DURATION = 50;     // Confirm action beep duration [ms]
    constexpr uint16_t BEEP_ERROR_FREQ = 200;          // Error beep frequency [Hz]
    constexpr uint16_t BEEP_ERROR_DURATION = 200;      // Error beep duration [ms]
    constexpr uint16_t BEEP_WARNING_DURATION = 100;    // Warning beep duration [ms]
    constexpr uint16_t BEEP_FAULT_FREQ = 1000;         // Fault alert frequency [Hz]
    constexpr uint16_t BEEP_FAULT_DURATION = 500;      // Fault alert duration [ms]

    // -------------------------------------------------------------------------
    // RGB LED Settings
    // -------------------------------------------------------------------------
    constexpr uint8_t RGB_LED_BRIGHTNESS_NORMAL = 50;  // Normal brightness (%)
    constexpr uint8_t RGB_LED_BRIGHTNESS_DIM = 2;      // Dimmed brightness (%)

    // -------------------------------------------------------------------------
    // USB PD Constants
    // -------------------------------------------------------------------------
    constexpr uint8_t MAX_PDO_COUNT = 13;              // Max PDOs (7 SPR + 6 EPR per USB-PD spec)
    constexpr uint32_t EPR_SPR_MAX_MV = 20000;         // EPR/SPR boundary: voltages >20V are EPR [mV]
    constexpr uint32_t EPR_PROBE_DELAY_MS = 150;       // Delay after EPR probe before reading PDOs [ms]

    // -------------------------------------------------------------------------
    // Constant Current Mode
    // -------------------------------------------------------------------------
    constexpr uint32_t CC_SAFETY_MARGIN_MA = 500;          // OCP margin above CC target [mA]
    constexpr uint32_t CC_POLL_INTERVAL_MS = 10;           // CC control loop interval [ms] (100Hz)
    constexpr uint32_t CC_PD_REQUEST_COOLDOWN_MS = 500;    // Min interval between PD voltage requests [ms]

    // -------------------------------------------------------------------------
    // Temperature Display
    // -------------------------------------------------------------------------
    constexpr uint32_t CRITICAL_BLINK_INTERVAL_MS = 250; // Blink interval for critical temp [ms]
}
