patrickstreit/PD240W/(commit log)

2026-10-31 Fix JLCPCB assembly data (BOM/CPL) and add Fabrication Toolkit output
    - Correct the 4.7k 0402 resistors (R8, R9, R11, R12, R18, R25, R30, R84,
    R89, R90): MPN 0402WGF1003TCE / LCSC C25741 was the 100k part, now
    0402WGF4701TCE / C25900.
    - Mark all footprints without a BOM entry (TP*, FD1-3, MH1-5, JP1-11,
    NT1) as "exclude from position files". Updating the PCB from the
    schematic had dropped this attribute, so the CPL listed parts that are
    not in the BOM and JLCPCB rejected it with "CPL does not match BOM".
    - Add Fabrication Toolkit config (Exclude DNP) and its JLCPCB output in
    PCB_files/production/: gerber/drill zip, bom.csv, positions.csv
    (209 parts, matches BOM 1:1).
    - Schemati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
    [Block Diagram.kicad_sch, PD240W_kicad.kicad_pcb, PD240W_kicad.kicad_sch, Power - Sequencing.kicad_sch, Project Architecture.kicad_sch, Revision History.kicad_sch, bom.csv, designators.csv]
2026-11-01 Fix swapped USB D+/D- and rework 17V aux buck to 5V
    - Schematic: swap USB_D_INT_P/N at RP2040 pins 46/47 (v1.0.0 erratum)
    - PCB: swap U9 pad nets, reassign MCU-side vias/stubs, remove the
    B.Cu diagonal and stale teardrops of the pair (re-route in KiCad)
    - Aux buck U12: R87 47k, R88 4.7k -> 4.97V; R86 1k for LED
    - Firmware: aux buck interlock 18V -> 7V, UI/CLI/docs labels
    Claude-Session: https://claude.ai/code/session_014YQ7UzS8vLVJ4sxcP9knz5
    [PD240W_kicad.kicad_pcb, mcu_unit.kicad_sch, power_generation.kicad_sch]
